PathOn-AI/PathOnRoboticsOSS/hardware/robots/so101_6dof_wrist/README.md

# SO-101 6DoF Wrist Upgrade





An upgrade kit for the [SO-101](https://github.com/TheRobotStudio/SO-ARM100) robotic arm, adding a **6th degree of freedom** (wrist pitch + yaw). The standard SO-101 is a 5DoF arm; two 3D-printed links replace the wrist so the arm can approach an object from any angle, which is what makes poses from off-the-shelf grasp-generation models reachable rather than merely computable.

Its companion is the [symmetric gripper](../../end_effectors/symmetric_gripper/) -- the two were designed together, and the gripper mounts onto the yaw link built here.

<p align="center">
  Assembled SO-101 6DoF with symmetric gripper
  <br>
  <em>Fully assembled SO-101 6DoF arm with symmetric gripper on a playground setup with overhead camera mount.</em>
</p>

<p align="center">
  MoveIt motion planning with point cloud
  <br>
  <em>RViz visualization showing MoveIt motion planning, robot model, TF frames, and point cloud overlay.</em>
</p>

## What's Included

Two printed links that replace the SO-101 wrist:

- `link_pitch` -- wrist pitch joint
- `link_yaw` -- wrist yaw joint

Plus the **simulation models for the whole arm**. `software/robot_assets/` holds the URDF and MJCF for the SO-101 with this wrist *and* the symmetric gripper as one kinematic chain -- there is no wrist-only or gripper-only model, so both live here.

## Prerequisites

You need a built [SO-101 arm](https://github.com/TheRobotStudio/SO-ARM100) as the base. This kit provides the parts for the 6DoF upgrade.

## Demos

The demos below exercise the complete assembly -- 6DoF wrist plus symmetric gripper.

### Vision-Language Grasping (Simulation)

We implement a vision-language grasping pipeline using SAM3 for segmentation and grasp generation models. Given a natural language command (e.g., "pick up the banana"), the system segments the target object and plans a grasp.

https://www.loom.com/share/2fed8ad63ee7416fad60bd227efd1a95

*Simulated pick-and-place with vision-language grasping.*

### MoveIt Motion Planning (Real Robot)

The real robot is integrated with ROS2 MoveIt for motion planning, with point cloud overlay for scene understanding.

https://www.loom.com/share/303cc35079a64f459af959ff9830bfd2

*MoveIt motion planning with point cloud overlay on the physical SO-101 6DoF arm.*

### Vision-Language Grasping (Real Robot)

Vision-language grasping running on the physical SO-101 6DoF arm.

https://www.loom.com/share/fe4379299d904ffc811d0ab0f7dc357c

*Real-robot pick-and-place with vision-language grasping.*

## Getting Started

1. Print the 3D parts -- see [hardware/](hardware/) for files and assembly instructions
2. Assemble the wrist upgrade onto your SO-101
3. Fit the [symmetric gripper](../../end_effectors/symmetric_gripper/)
4. Software integration -- coming soon

## 📰 News

| Date | Release |
|---|---|
| -- | Software release: digital twin, ROS2, MoveIt config, MuJoCo simulation (coming soon) |
| 2026-04-16 | Demo video: vision-language grasping (real robot) |
| 2026-04-14 | Software release: URDF, MJCF, and meshes for SO-101 6DoF symmetric gripper |
| 2026-04-13 | Assembly guide with images and print orientation for 6DoF wrist and gripper |
| 2026-04-12 | Bill of materials for 6DoF wrist upgrade and symmetric gripper |
| 2026-04-07 | Demo videos: vision-language grasping (simulation), MoveIt motion planning with point cloud (real robot) |
| 2026-04-07 | Hardware release: 6DoF wrist (pitch + yaw) STL/STEP files, symmetric gripper STL/STEP files |

## License

Hardware files in this project — CAD, meshes, assembly docs, and photos — are
covered by the [hardware LICENSE](../../LICENSE), a Standard Digital File License:

- **Personal use** — print, build, and modify these for your own personal,
  non-commercial use.
- **No redistribution** — do not repost the files or printed parts anywhere,
  free or paid, including remixes.
- **No organizational or commercial use** without written permission — this
  applies to companies, schools, and universities alike, and covers selling the
  files or prints *and* using the parts in a product, production line, service,
  course, or lab.

Licensing for organizations, including schools and universities, is available —
contact the copyright holder.

**Exception:** the meshes of the SO-101 arm body under
[`software/robot_assets/`](software/robot_assets/) are derived from
[SO-ARM100](https://github.com/TheRobotStudio/SO-ARM100) and remain under the
Apache License 2.0 — see the [NOTICE](software/robot_assets/NOTICE).
