PathOn-AI/PathOnRoboticsOSS/hardware/so101_6dof_symmetric_gripper/software/README.md

# Software

## Robot Assets

Robot description files and meshes for simulation and motion planning.

| File | Description |
|---|---|
| [URDF](robot_assets/so101_PathonAI_6dof_symmetric_gripper.urdf) | Robot description for ROS2 / RViz / MoveIt |
| [MJCF](robot_assets/so101_PathonAI_6dof_symmetric_gripper.xml) | MuJoCo simulation model |
| [meshes/](robot_assets/meshes/) | STL mesh files for all 9 links |

## Coming Soon

ROS2 integration, MoveIt config, digital twin, and MuJoCo simulation examples.
