PathOn-AI/PathOnRoboticsOSS/website/content/robots/amazing-hand.md

---
name: "Amazing Hand"
kind: "end_effector"
maker: "Pollen Robotics"
category: "Dexterous Hand"
description: "Self-contained, 3D-printed robotic hand with 8 DOF costing under €200, covered with TPU shell. Four fingers with two motors each."
link: "https://github.com/pollen-robotics/AmazingHand"
image: "/robots/amazing-hand.jpg"
specs:
  dof: "8"
  weight: "~0.3 kg"
  payload: "N/A"
  price: "< €200"
  controller: "Arduino / External"
  interfaces: "Serial, Python"
  power: "DC 5V"
  status: "Open Source / DIY"
purpose:
  - "Research"
  - "Hobby"
components:
  - name: "Micro Servos"
    type: "Actuators (x8)"
  - name: "3D-Printed Frame"
    type: "PLA"
  - name: "TPU Shell"
    type: "Protective Cover"
  - name: "Arduino Board"
    type: "Compute"
---

## Overview

The Amazing Hand by Pollen Robotics is a self-contained, 3D-printed dexterous robotic hand. It offers 8 degrees of freedom with four fingers (two motors each) at a cost under €200.

## Use Cases

- Dexterous manipulation research
- Grasping and in-hand manipulation
- Prosthetics prototyping
- Human-robot interaction studies
