PathOn-AI/PathOnRoboticsOSS/website/content/robots/cyberbrick.md

---
name: "CyberBrick by Bambu Lab"
kind: "robot"
maker: "Bambu Lab"
category: "DIY Kits"
description: "Modular hardware kit enabling 3D printing designers to build functional robots — arms, combat robots, vehicles, and droids."
link: "https://makerworld.com/en/cyberbrick"
image: "/robots/cyberbrick.png"
specs:
  dof: "Varies by build"
  price: "~$50+ (modules)"
  controller: "CyberBrick Controller"
  interfaces: "Bambu App, Bluetooth"
  power: "Li-Ion Battery Pack"
  status: "Commercial / DIY"
purpose:
  - "Hobby"
  - "Education"
components:
  - name: "CyberBrick Servo Modules"
    type: "Actuators"
  - name: "CyberBrick Controller"
    type: "Compute"
  - name: "3D-Printed Parts"
    type: "Frame (MakerWorld)"
  - name: "Battery Module"
    type: "Power"
---

## Overview

CyberBrick by Bambu Lab is a modular hardware kit that brings 3D-printed robots to life. It provides standardized electronic modules that snap into 3D-printed structures, enabling makers to build functional robots without complex wiring.

## Community Projects

The CyberBrick ecosystem on MakerWorld includes robotic arms, combat robots, RC vehicles, walking robots, and custom animatronics.

## Use Cases

- STEM education and maker projects
- Rapid prototyping of robot designs
- Community-driven robot building
- Introduction to robotics for beginners
