PathOn-AI/PathOnRoboticsOSS/website/content/robots/jetauto-pro.md

---
name: "HIWONDER JetAuto Pro"
kind: "robot"
maker: "Hiwonder"
category: "Mobile Manipulator"
description: "ROS2-enabled autonomous vehicle platform for navigation and perception research."
link: "https://www.amazon.com/dp/B0C2VZLJCL"
image: "/robots/jetauto-pro.jpg"
specs:
  dof: "4 (base) + 4 (arm)"
  weight: "~3 kg"
  payload: "~200 g (arm)"
  price: "~$800"
  controller: "NVIDIA Jetson Nano"
  interfaces: "ROS2, Python, OpenCV"
  power: "Rechargeable Li-Ion"
  status: "Commercial"
purpose:
  - "Education"
  - "Research"
components:
  - name: "NVIDIA Jetson Nano"
    type: "Onboard Compute"
  - name: "4-DOF Robotic Arm"
    type: "Manipulator"
  - name: "Mecanum Wheels"
    type: "Drive (x4)"
  - name: "Depth Camera"
    type: "Vision"
  - name: "LiDAR"
    type: "Navigation"
---

## Overview

The HIWONDER JetAuto Pro is a ROS2-enabled autonomous vehicle platform combining a mobile base with a robotic arm. It is designed for integrated navigation, perception, and manipulation research.

## Use Cases

- Mobile manipulation research
- Autonomous driving and navigation
- Object detection and pick-and-place
- Multi-task robot learning
