PathOn-AI/PathOnRoboticsOSS/website/content/robots/mentorpi.md

---
name: "Hiwonder MentorPi"
kind: "robot"
maker: "Hiwonder"
category: "Mobile Base"
description: "ROS2 robot powered by Raspberry Pi 5 with 3D depth camera, TOF LiDAR, and SLAM navigation. Three chassis variants available."
link: "https://www.hiwonder.com/products/mentorpi-m1"
image: "/robots/mentorpi.jpg"
specs:
  dof: "4 (varies by chassis)"
  weight: "~2 kg"
  price: "~$400"
  controller: "Raspberry Pi 5"
  interfaces: "ROS2, Python, OpenCV"
  power: "Rechargeable Li-Ion"
  status: "Commercial"
purpose:
  - "Education"
components:
  - name: "Raspberry Pi 5"
    type: "Onboard Compute"
  - name: "3D Depth Camera"
    type: "Vision"
  - name: "TOF LiDAR"
    type: "Range Sensor"
  - name: "Mecanum / Ackermann / Tank Chassis"
    type: "Drive Base (3 options)"
---

## Overview

The Hiwonder MentorPi is a ROS2 educational mobile robot powered by Raspberry Pi 5. It comes with a rich sensor suite and offers three interchangeable chassis options: Mecanum, Ackermann, and tank treads.

## Use Cases

- ROS2 education and curriculum development
- SLAM and navigation experiments
- Multi-sensor fusion research
- Comparing different locomotion strategies
