PathOn-AI/PathOnRoboticsOSS/website/content/robots/mycobot-280.md

---
name: "Elephant Robotics myCobot 280 Pi"
kind: "robot"
maker: "Elephant Robotics"
category: "Robotic Arm"
description: "6-DOF collaborative robot powered by Raspberry Pi 4B. Supports Python, C++, ROS, and Arduino with AI kit and adaptive gripper."
link: "https://shop.elephantrobotics.com/collections/mycobot-280/products/holiday-mycobot-pi-raspberry-pi-powered-6-dof-collaborative-robot"
image: "/robots/mycobot-280.jpg"
specs:
  dof: "6"
  weight: "0.98 kg"
  payload: "250 g"
  reach: "280 mm"
  price: "~$600"
  controller: "Raspberry Pi 4B"
  interfaces: "Python, C++, ROS, ROS2, Arduino"
  power: "DC 12V"
  repeatability: "±0.5 mm"
  status: "Commercial"
purpose:
  - "Education"
  - "Research"
components:
  - name: "Custom Serial Servos"
    type: "Servos (x6)"
  - name: "Raspberry Pi 4B"
    type: "Onboard Compute"
  - name: "Adaptive Gripper"
    type: "End Effector"
  - name: "AI Kit Camera"
    type: "Vision (optional)"
---

## Overview

The myCobot 280 Pi is a compact 6-DOF collaborative robot arm from Elephant Robotics, powered by a Raspberry Pi 4B. It is designed for education, research, and light industrial applications.

## Use Cases

- ROS2 development and education
- Visual servoing and pick-and-place
- Lightweight manipulation research
