PathOn-AI/PathOnRoboticsOSS/website/content/robots/puppypi.md

---
name: "Hiwonder PuppyPi"
kind: "robot"
maker: "Hiwonder"
category: "Quadruped"
description: "ROS quadruped robot powered by Raspberry Pi 5 with AI vision, 8 coreless servos, OpenCV, and SLAM mapping."
link: "https://www.hiwonder.com/products/puppypi"
image: "/robots/puppypi.jpg"
specs:
  dof: "8"
  weight: "~0.6 kg"
  price: "~$300"
  controller: "Raspberry Pi 5"
  interfaces: "ROS, Python, OpenCV"
  power: "Li-Ion 7.4V"
  status: "Commercial"
purpose:
  - "Education"
  - "Hobby"
components:
  - name: "Coreless Servos"
    type: "Actuators (x8)"
  - name: "Raspberry Pi 5"
    type: "Onboard Compute"
  - name: "USB Camera"
    type: "Vision"
  - name: "LiDAR"
    type: "Navigation (optional)"
  - name: "Robotic Arm"
    type: "Manipulator (optional)"
---

## Overview

The Hiwonder PuppyPi is a ROS-compatible quadruped robot powered by Raspberry Pi 5. It features AI-powered vision with OpenCV and 8 coreless servos for dynamic walking gaits.

## Use Cases

- Quadruped locomotion research
- Legged robot gait learning
- Computer vision on mobile platforms
- STEM education
