PathOn-AI/PathOnRoboticsOSS/website/content/robots/rosmaster-x3.md

---
name: "ROSMASTER X3 ROS2 Robot"
kind: "robot"
maker: "Yahboom"
category: "Mobile Base"
description: "Mecanum wheel robot enabling omnidirectional movement for ROS2 development."
link: "https://www.robotshop.com/products/yahboom-rosmaster-x3-ros2-robot-with-mecanum-wheel-advanced-without-orin-super-board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"
image: "/robots/rosmaster-x3.jpg"
specs:
  dof: "4 (mecanum wheels)"
  weight: "~2.5 kg"
  payload: "~3 kg"
  price: "~$500"
  controller: "NVIDIA Jetson / Raspberry Pi"
  interfaces: "ROS2, Python"
  power: "Li-Ion 12.6V"
  status: "Commercial"
purpose:
  - "Education"
  - "Research"
components:
  - name: "Mecanum Wheels"
    type: "Drive (x4)"
  - name: "NVIDIA Jetson Orin"
    type: "Compute (optional)"
  - name: "Depth Camera"
    type: "Vision"
  - name: "LiDAR"
    type: "2D LiDAR"
  - name: "IMU"
    type: "Inertial Sensor"
---

## Overview

The ROSMASTER X3 by Yahboom is a ROS2-compatible mobile robot featuring mecanum wheels for omnidirectional movement. It is a versatile platform for navigation and perception research.

## Use Cases

- Omnidirectional navigation research
- Indoor autonomous delivery prototyping
- SLAM and mapping with various sensor configurations
- Mobile manipulation base platform
