PathOn-AI/PathOnRoboticsOSS/website/content/robots/turtlebot4.md

---
name: "Clearpath Robotics TurtleBot 4"
kind: "robot"
maker: "Clearpath Robotics"
category: "Mobile Base"
description: "Industry-standard mobile robot for ROS2 development and education."
link: "https://www.robotshop.com/products/clearpath-robotics-turtlebot-4-mobile-robot?variant=42360573362337"
image: "/robots/turtlebot4.jpg"
specs:
  dof: "2 (differential drive)"
  weight: "~3.4 kg"
  payload: "~9 kg"
  price: "~$1,200"
  controller: "Raspberry Pi 4"
  interfaces: "ROS2, Nav2, Python"
  power: "Rechargeable Li-Ion"
  status: "Commercial"
purpose:
  - "Education"
  - "Research"
components:
  - name: "iRobot Create 3"
    type: "Drive Base"
  - name: "Raspberry Pi 4"
    type: "Onboard Compute"
  - name: "RPLIDAR A1"
    type: "2D LiDAR"
  - name: "OAK-D Camera"
    type: "Depth Camera"
  - name: "IMU"
    type: "Inertial Sensor"
---

## Overview

The TurtleBot 4 by Clearpath Robotics is the industry-standard mobile robot platform for ROS2 development. Built on the iRobot Create 3, it is the go-to platform for learning and teaching ROS2 navigation and perception.

## Use Cases

- ROS2 navigation and SLAM education
- Autonomous mobile robot research
- Multi-robot coordination experiments
- Perception and mapping benchmarks
