PathOn-AI/PathOnRoboticsOSS/software/iphone_sensor_suite/images/iphone_aruco.png

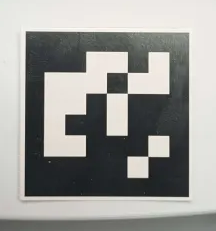
software/iphone_sensor_suite/images/iphone_aruco.png
