PathOn-AI/PathOnRoboticsOSS/software/iphone_sensor_suite/images/iphone_aruco_orientation.png

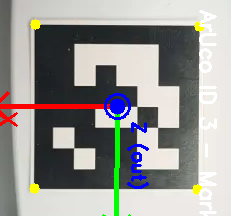
software/iphone_sensor_suite/images/iphone_aruco_orientation.png
