PathOn-AI/PathOnRoboticsOSS/software/iphone_sensor_suite/Scanner3D/example_scan/2026-03-23--19-45-00/capture_000001/depth_vis.png

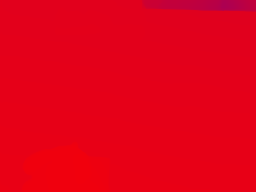
software/iphone_sensor_suite/Scanner3D/example_scan/2026-03-23--19-45-00/capture_000001/depth_vis.png
