PathOn-AI/PathOnRoboticsOSS/hardware/end_effectors/symmetric_gripper/hardware/3d_printed_parts/symmetric_gripper/step/Parallel_gripper_assembly.step

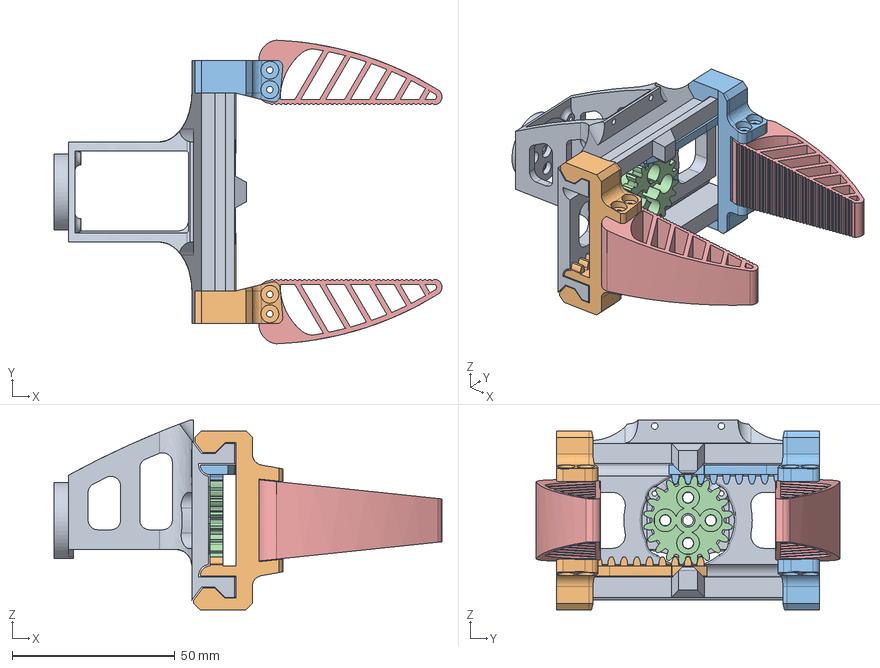
[picture p60: CAD file, 2026-07-22]
hardware/end_effectors/symmetric_gripper/hardware/3d_printed_parts/symmetric_gripper/step/Parallel_gripper_assembly.step
119.3 x 93.4 x 58.4 mm
