PathOn-AI/PathOnRoboticsOSS/hardware/end_effectors/dexterous_hand/v3/stl/thumb_finger_link.stl

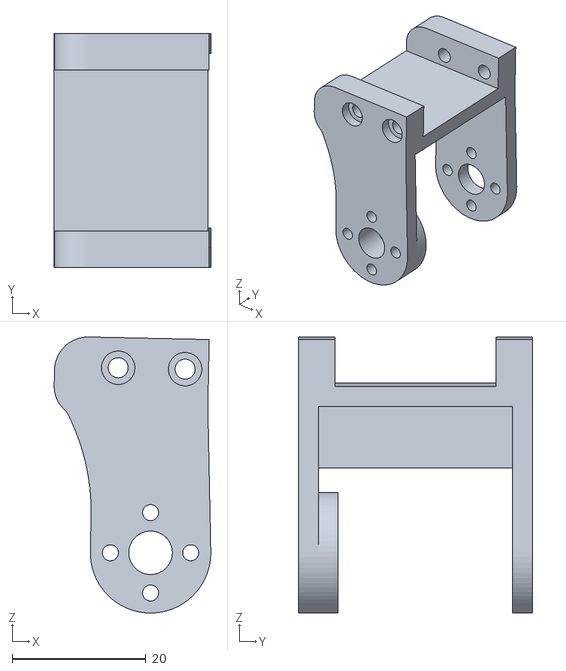
[picture p62: CAD file, 2026-11-03]
hardware/end_effectors/dexterous_hand/v3/stl/thumb_finger_link.stl
23.4 x 35.0 x 41.2
