PathOn-AI/PathOnRoboticsOSS/hardware/end_effectors/symmetric_gripper/hardware/3d_printed_parts/symmetric_gripper/stl/l_gripper.stl

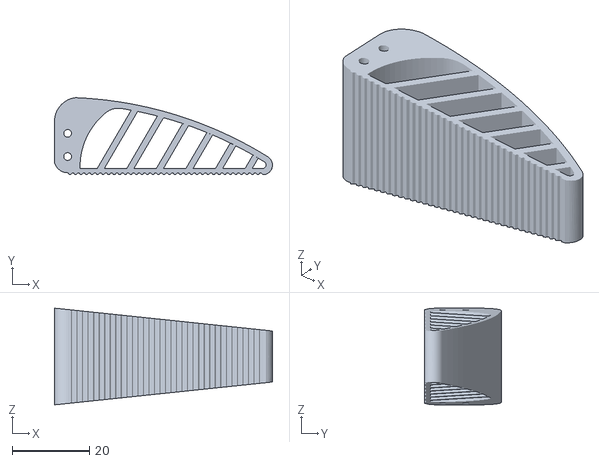
[picture p63: CAD file, 2026-07-22]
hardware/end_effectors/symmetric_gripper/hardware/3d_printed_parts/symmetric_gripper/stl/l_gripper.stl
56.3 x 19.8 x 25.0
