PathOn-AI/PathOnRoboticsOSS/hardware/mounts/livox_mid360_go2_mount/cad/livox_mid360_mount.stl

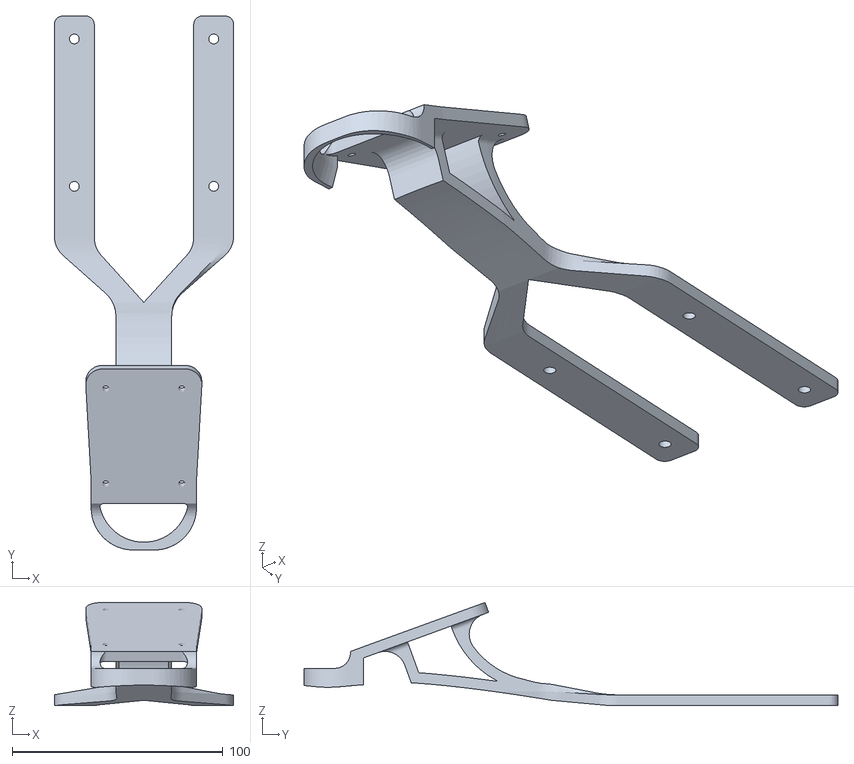
[picture p64: CAD file, 2026-05-06]
hardware/mounts/livox_mid360_go2_mount/cad/livox_mid360_mount.stl
85.2 x 253.6 x 48.9
