PathOn-AI/PathOnRoboticsOSS/hardware/robots/openarm_leader/cad_files/step/waveshare_mount.step

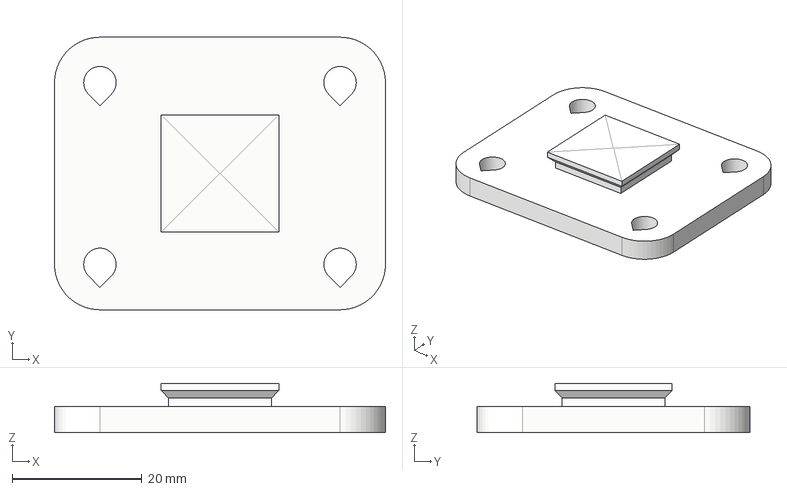
[picture p65: CAD file, 2026-10-23]
hardware/robots/openarm_leader/cad_files/step/waveshare_mount.step
51.0 x 42.0 x 7.60 mm
