PathOn-AI/PathOnRoboticsOSS/hardware/robots/openarm_leader/cad_files/stl/j4.stl

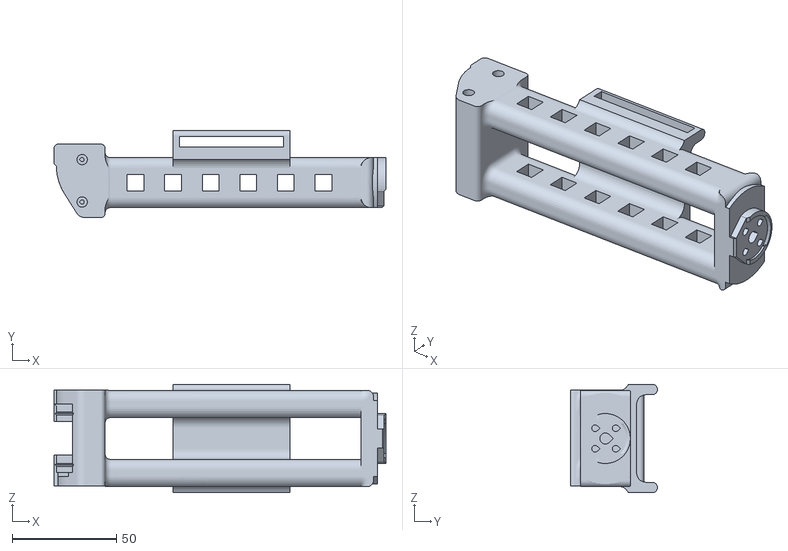
[picture p66: CAD file, 2026-10-23]
hardware/robots/openarm_leader/cad_files/stl/j4.stl
159.2 x 41.7 x 52.0
