PathOn-AI/PathOnRoboticsOSS/hardware/robots/piper_leader/cad/piper_leader.step

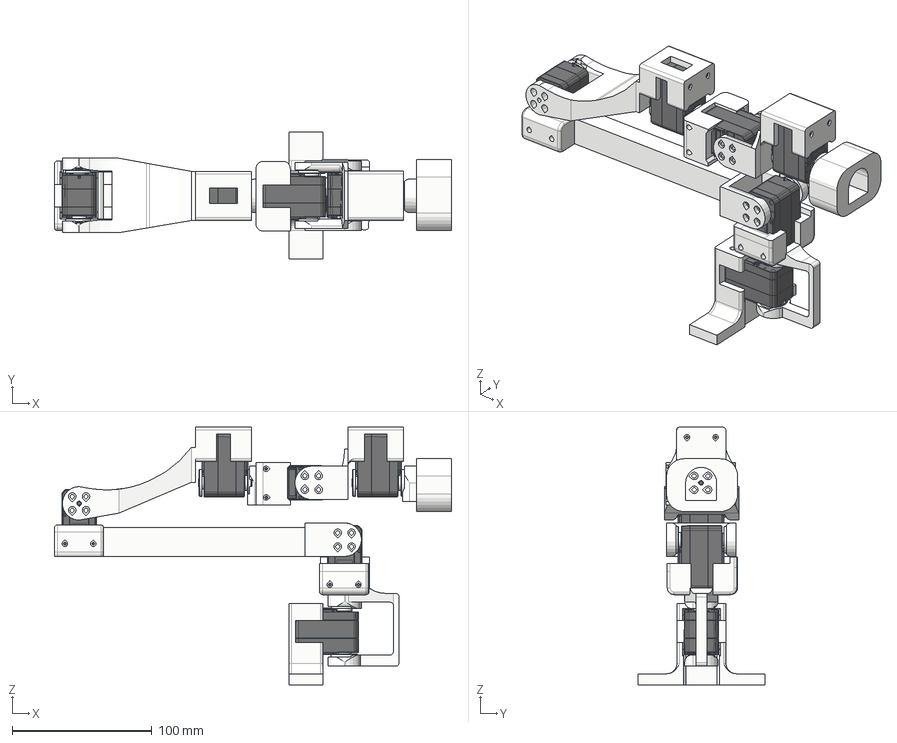
[picture p67: CAD file, 2026-07-14]
hardware/robots/piper_leader/cad/piper_leader.step
284.5 x 91.2 x 184.6 mm
Upper_arm_SO101
ZK_122 x 2
SG-ZIJI_15 x 2
XG-ZIJI_16 x 2
MOTOR-1723_3 x 2
PCB-CHAZUO_92 x 2
GE_27 x 2
金属舵盘（驱动） x 2
金属舵盘（从动） x 2
Upper_arm_SO101_1
ZK_122_1 x 4
SG-ZIJI_15_1 x 4
XG-ZIJI_16_1 x 4
MOTOR-1723_3_1 x 4
PCB-CHAZUO_92_1 x 4
GE_27_1 x 4
金属舵盘（驱动）_1 x 4
金属舵盘（从动）_1 x 4
Upper_arm_SO101_2
Upper_arm_SO101_3
Upper_arm_SO101_4
Upper_arm_SO101_5
Upper_arm_SO101_6
