PathOn-AI/PathOnRoboticsOSS/hardware/robots/piper_leader/cad/stl/lower_arm.stl

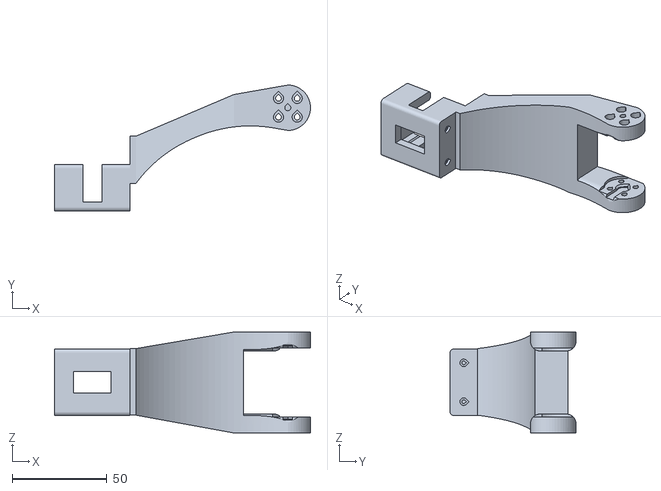
[picture p68: CAD file, 2026-10-23]
hardware/robots/piper_leader/cad/stl/lower_arm.stl
135.4 x 66.6 x 53.4
