PathOn-AI/PathOnRoboticsOSS/hardware/robots/piper_leader/stl/pitch.stl

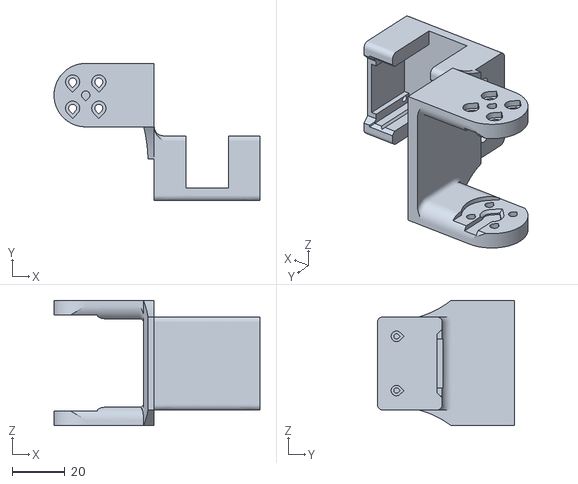
[picture p69: CAD file, 2026-10-22]
hardware/robots/piper_leader/stl/pitch.stl
77.9 x 51.9 x 47.4
