PathOn-AI/PathOnRoboticsOSS/hardware/robots/so101_6dof_wrist/hardware/3d_printed_parts/6dof/step/link_pitch.step

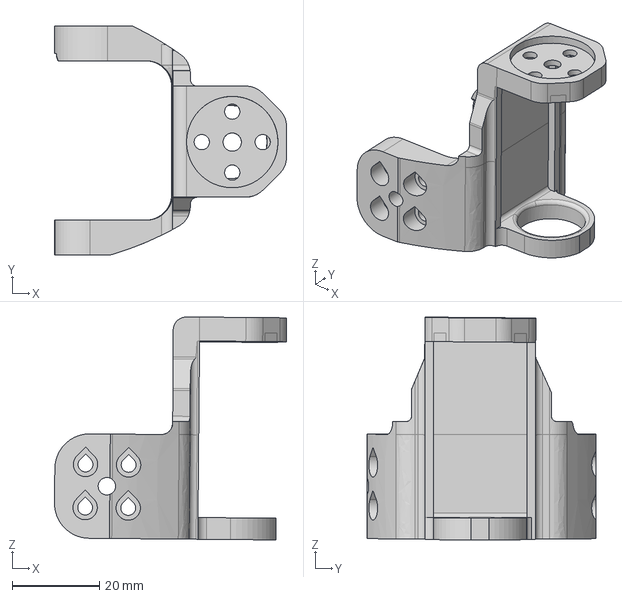
[picture p70: CAD file, 2026-04-14]
hardware/robots/so101_6dof_wrist/hardware/3d_printed_parts/6dof/step/link_pitch.step
53.3 x 52.6 x 51.2 mm
