PathOn-AI/PathOnRoboticsOSS/hardware/robots/so101_6dof_wrist/software/robot_assets/meshes/right_jaw_v1_1.stl

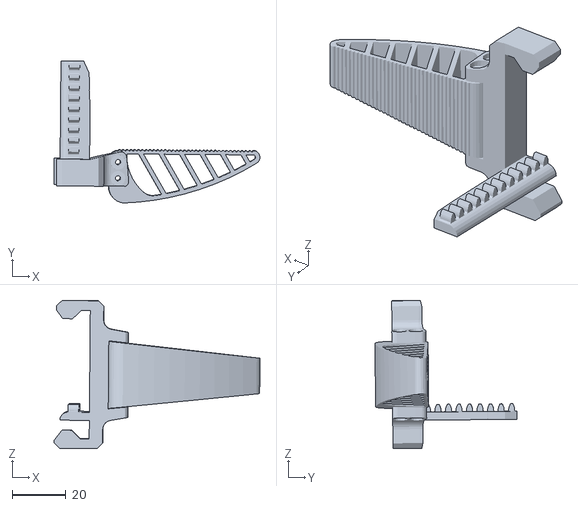
[picture p71: CAD file, 2026-04-14]
hardware/robots/so101_6dof_wrist/software/robot_assets/meshes/right_jaw_v1_1.stl
76.8 x 53.0 x 55.3
