PathOn-AI/PathOnRoboticsOSS/hardware/so101_6dof_symmetric_gripper/hardware/3d_printed_parts/6dof/step/link_yaw.step

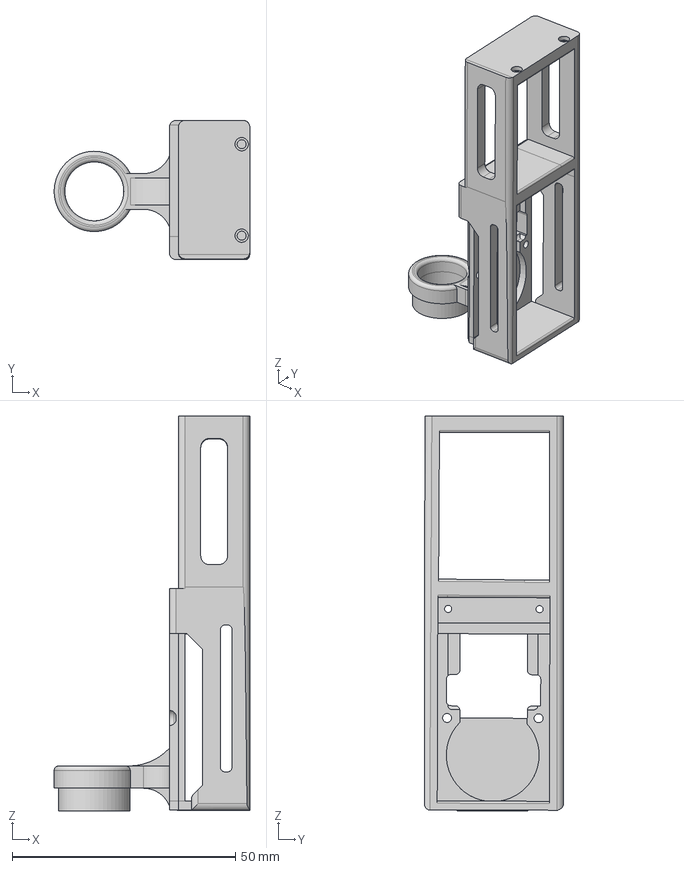
[picture p72: CAD file, 2026-04-14]
hardware/so101_6dof_symmetric_gripper/hardware/3d_printed_parts/6dof/step/link_yaw.step
43.8 x 31.2 x 88.5 mm
