PathOn-AI/PathOnRoboticsOSS/hardware/so101_6dof_symmetric_gripper/software/robot_assets/meshes/link_roll_v1_1.stl

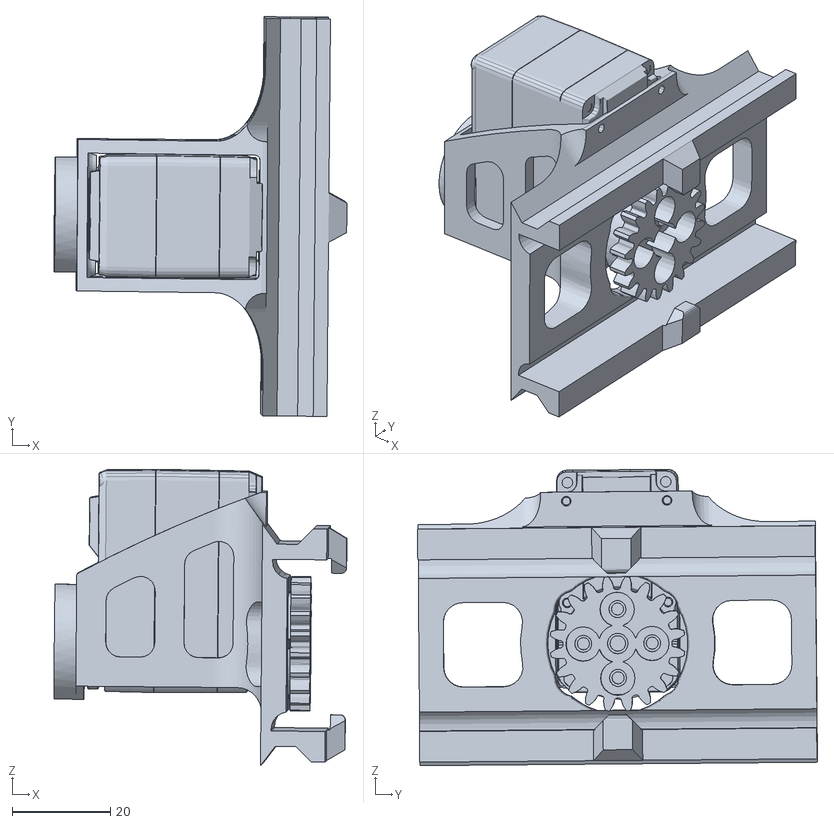
[picture p73: CAD file, 2026-04-14]
hardware/so101_6dof_symmetric_gripper/software/robot_assets/meshes/link_roll_v1_1.stl
59.6 x 81.3 x 60.3
