PathOn-AI/PathOnRoboticsOSS/software/diy_pipeline/robot-assets-skills/robots/allegro_right/assets/base_link_left.stl

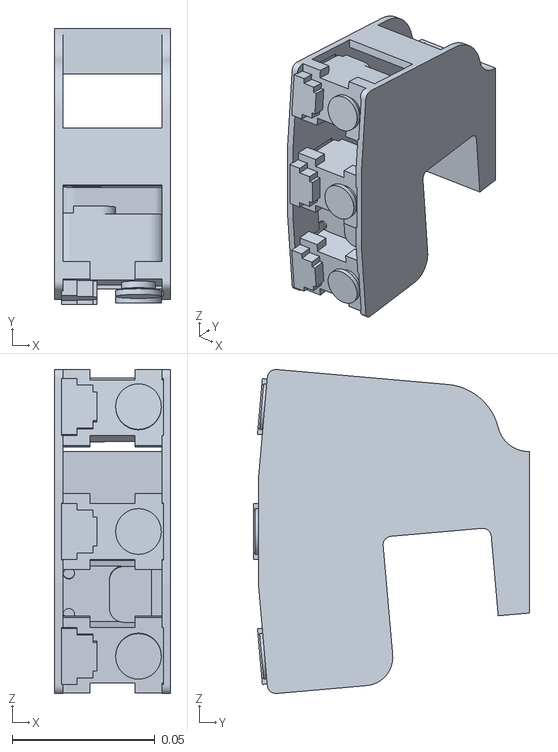
[picture p74: CAD file, 2026-05-08]
software/diy_pipeline/robot-assets-skills/robots/allegro_right/assets/base_link_left.stl
0.0408 x 0.0967 x 0.113
