PathOn-AI/PathOnRoboticsOSS/software/diy_pipeline/robot-assets-skills/robots/allegro_right/meshes/link_0.0.STL

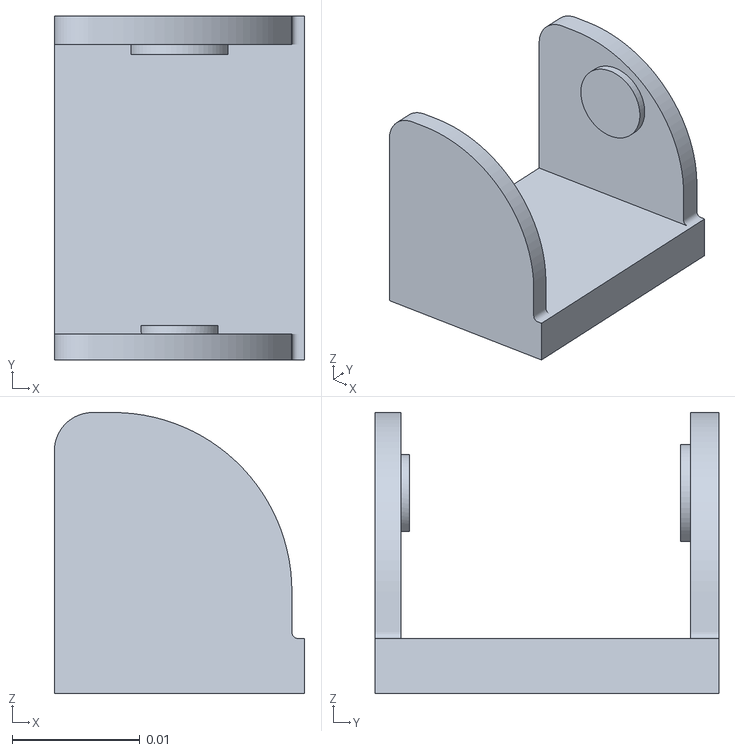
[picture p75: CAD file, 2026-05-08]
software/diy_pipeline/robot-assets-skills/robots/allegro_right/meshes/link_0.0.STL
0.0196 x 0.0269 x 0.022
