PathOn-AI/PathOnRoboticsOSS/software/diy_pipeline/robot-assets-skills/robots/piper_arm/assets/base_link.stl

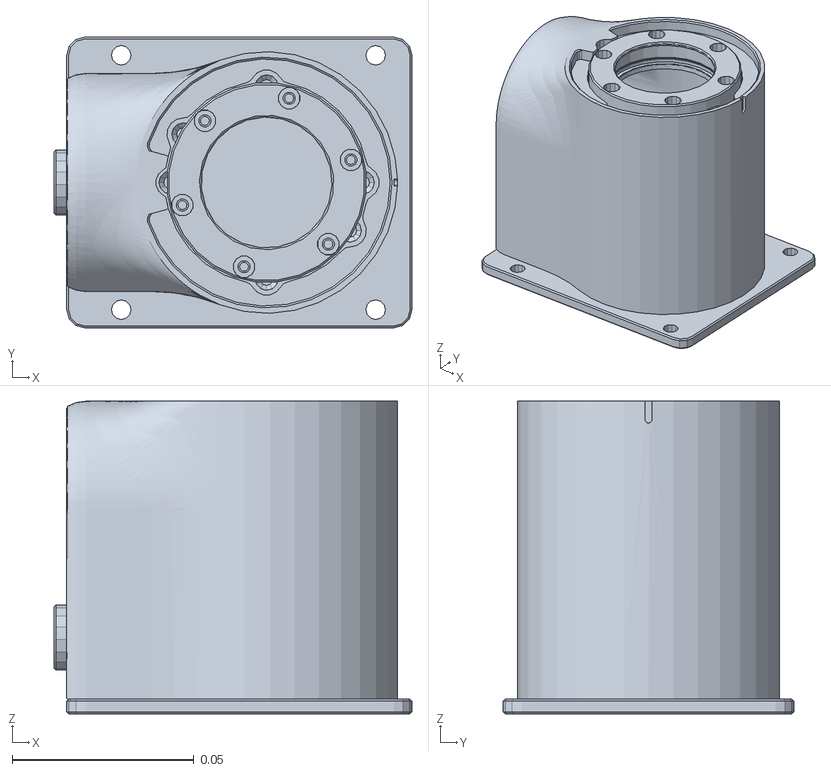
[picture p76: CAD file, 2026-05-08]
software/diy_pipeline/robot-assets-skills/robots/piper_arm/assets/base_link.stl
0.0985 x 0.08 x 0.086
