PathOn-AI/PathOnRoboticsOSS/software/diy_pipeline/robot-assets-skills/robots/piper_arm/meshes/link1.STL

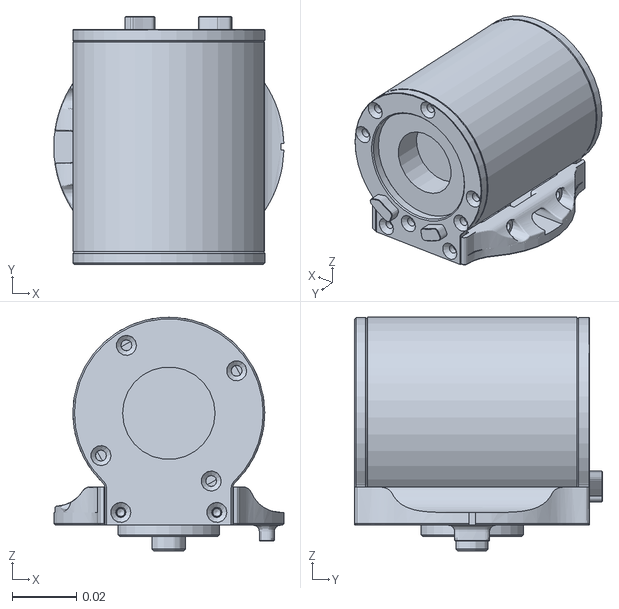
[picture p77: CAD file, 2026-05-08]
software/diy_pipeline/robot-assets-skills/robots/piper_arm/meshes/link1.STL
0.0719 x 0.0775 x 0.073
