PathOn-AI/PathOnRoboticsOSS/hardware/end_effectors/dexterous_hand/v3/cad/Part16_straight^dex_hand.SLDPRT

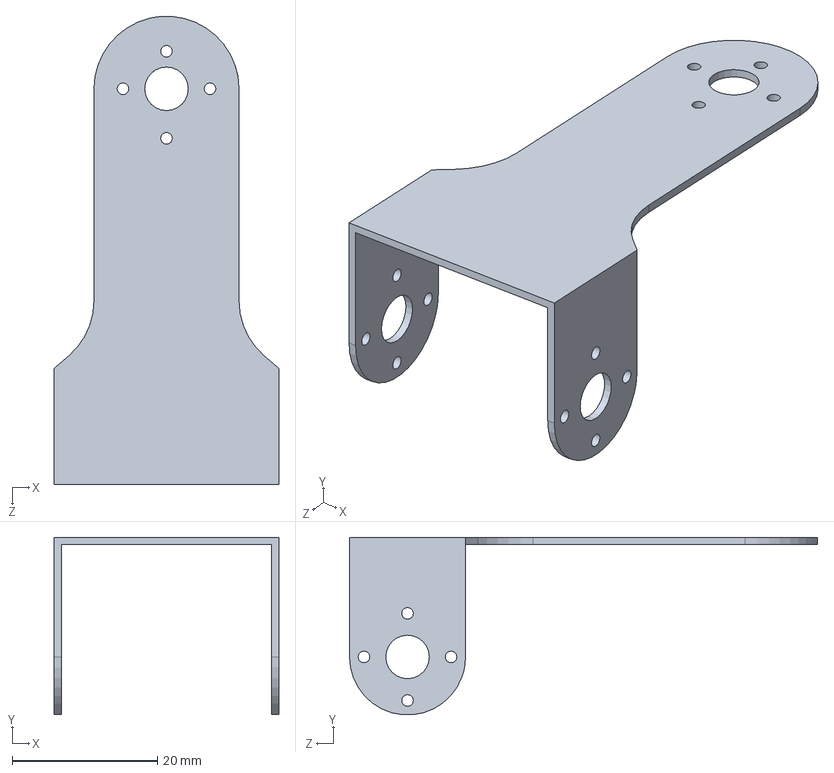
[picture p78: CAD file, 2026-08-09]
hardware/end_effectors/dexterous_hand/v3/cad/Part16_straight^dex_hand.SLDPRT
31.0 x 24.5 x 64.5 mm
