PathOn-AI/PathOnRoboticsOSS/hardware/end_effectors/dexterous_hand/v3/stl/soft_fin_half_mod.stl

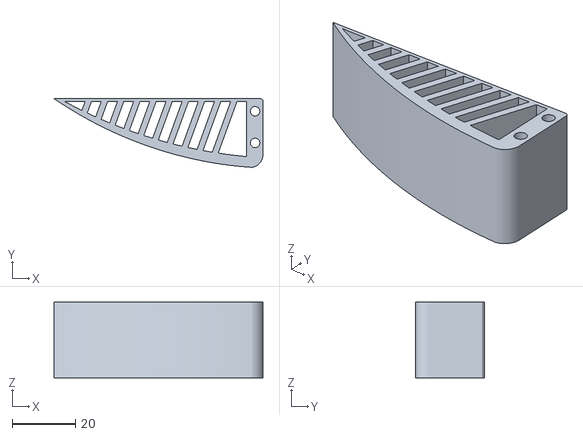
[picture p79: CAD file, 2026-11-03]
hardware/end_effectors/dexterous_hand/v3/stl/soft_fin_half_mod.stl
66.0 x 21.7 x 24.0
