PathOn-AI/PathOnRoboticsOSS/hardware/robots/openarm_leader/cad_files/step/j6.step

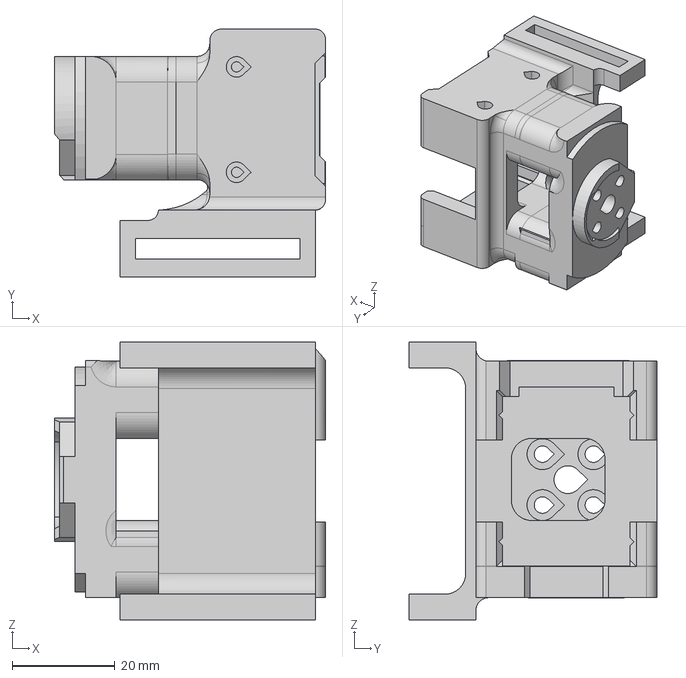
[picture p80: CAD file, 2026-10-23]
hardware/robots/openarm_leader/cad_files/step/j6.step
52.7 x 48.2 x 54.0 mm
Under_arm_SO101 v1
