PathOn-AI/PathOnRoboticsOSS/hardware/robots/piper_leader/stl/upper_arm.stl

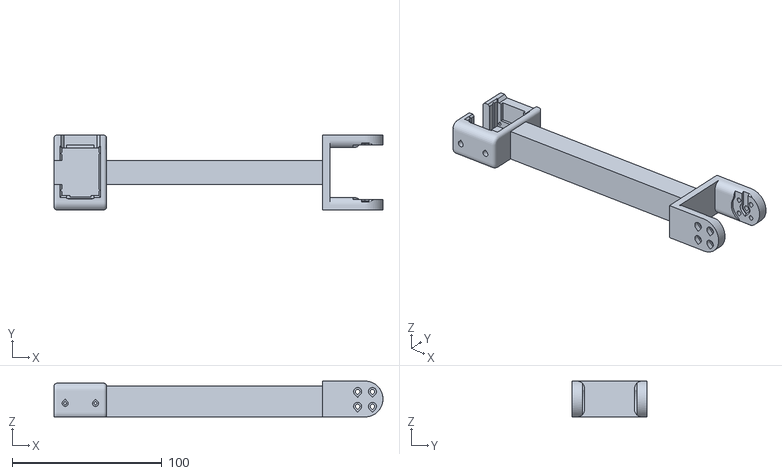
[picture p81: CAD file, 2026-10-22]
hardware/robots/piper_leader/stl/upper_arm.stl
219.9 x 50.1 x 24.0
