PathOn-AI/PathOnRoboticsOSS/hardware/so101_6dof_symmetric_gripper/software/robot_assets/meshes/lower_arm_link_1.stl

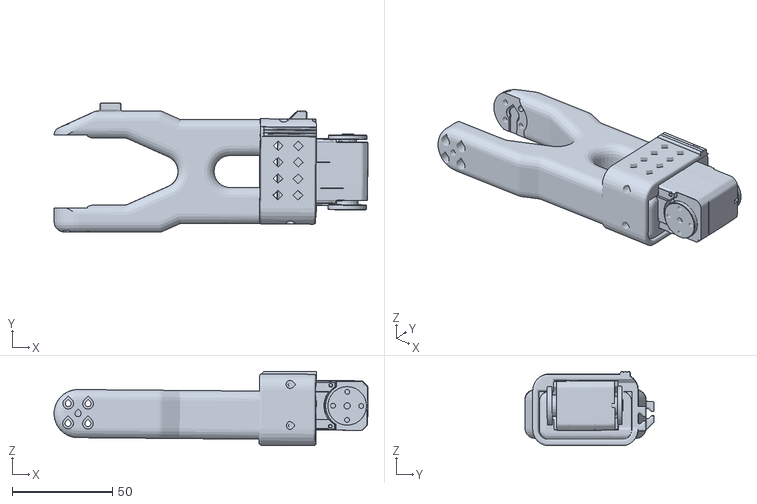
[picture p82: CAD file, 2026-04-14]
hardware/so101_6dof_symmetric_gripper/software/robot_assets/meshes/lower_arm_link_1.stl
156.5 x 64.4 x 37.1
