PathOn-AI/PathOnRoboticsOSS/software/diy_pipeline/robot-assets-skills/robots/piper_arm/assets/link3_8.obj

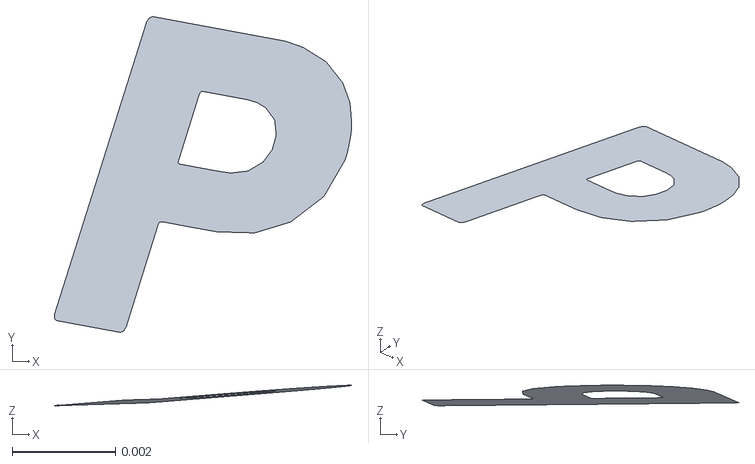
[picture p84: CAD file, 2026-05-08]
software/diy_pipeline/robot-assets-skills/robots/piper_arm/assets/link3_8.obj
0.00577 x 0.00613 x 0.000399
