PathOn-AI/PathOnRoboticsOSS/software/diy_pipeline/robot-assets-skills/robots/piper_arm/meshes/link4.STL

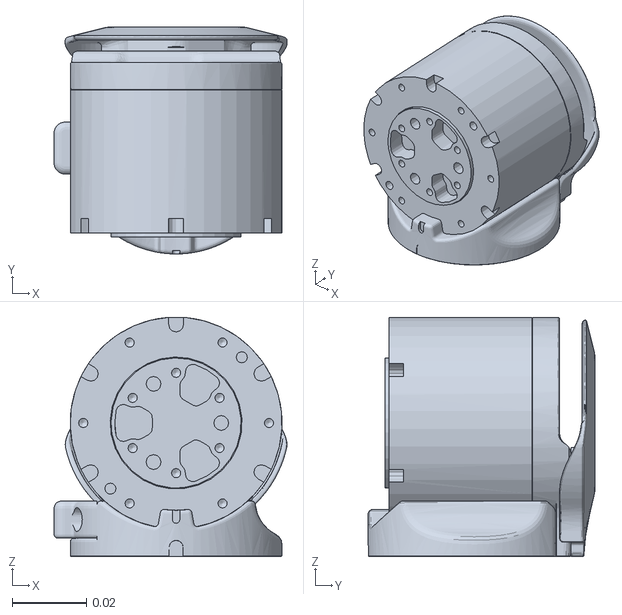
[picture p85: CAD file, 2026-05-08]
software/diy_pipeline/robot-assets-skills/robots/piper_arm/meshes/link4.STL
0.0627 x 0.0611 x 0.0644
