PathOn-AI/PathOnRoboticsOSS/hardware/end_effectors/dexterous_hand/v3/cad/XL,XC-330.stp

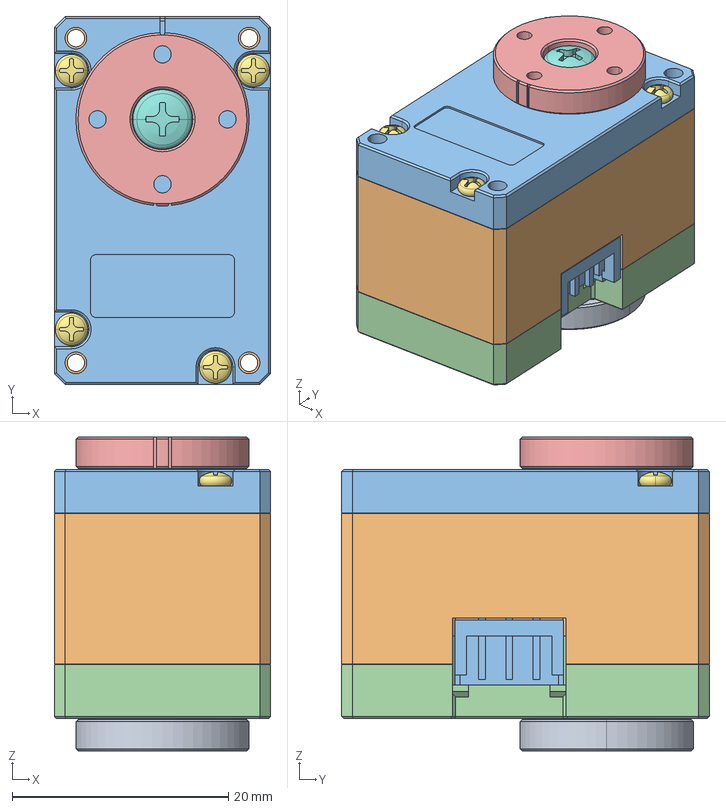
[picture p86: CAD file, 2026-08-09]
hardware/end_effectors/dexterous_hand/v3/cad/XL,XC-330.stp
20.0 x 34.0 x 29.0 mm
DC15_A01_CASE_M_DUMMY
DC15_A01_CASE_F_DUMMY
DC15_A01_CASE_B_DUMMY
DC15_A01_HORN_DUMMY
DC15_A01_LED_CAP2_DUMMY
PHS_1_7X20_5_DC10 x 4
BTS2_M2_6X8 x 2
DC15_A01_HORN_IDLE2_DUMMY
DC15_A01_IDLE_CAP_DUMMY
B3B-EH x 2
