PathOn-AI/PathOnRoboticsOSS/hardware/end_effectors/dexterous_hand/v3/stl/arm_J7_A.stl

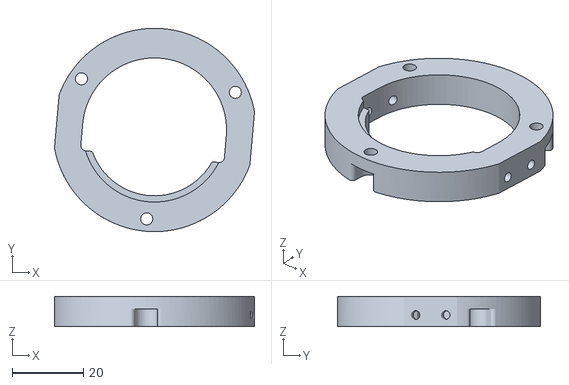
[picture p87: CAD file, 2026-11-03]
hardware/end_effectors/dexterous_hand/v3/stl/arm_J7_A.stl
56.1 x 57.0 x 8.50
