PathOn-AI/PathOnRoboticsOSS/hardware/end_effectors/symmetric_gripper/hardware/3d_printed_parts/symmetric_gripper/stl/rack_up.stl

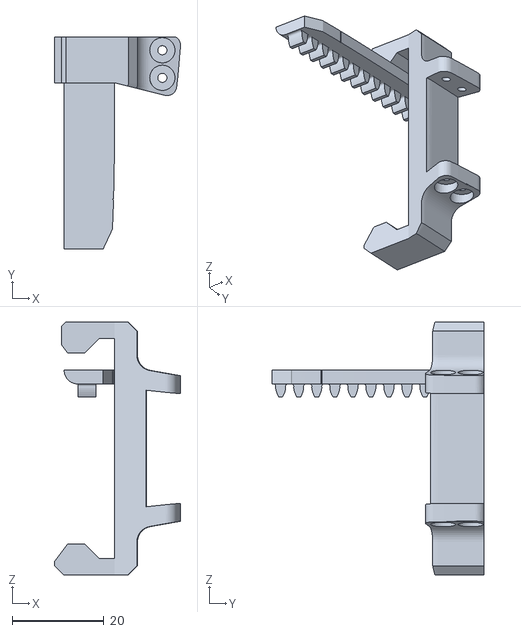
[picture p88: CAD file, 2026-04-14]
hardware/end_effectors/symmetric_gripper/hardware/3d_printed_parts/symmetric_gripper/stl/rack_up.stl
27.5 x 46.2 x 55.1
