PathOn-AI/PathOnRoboticsOSS/hardware/robots/openarm_leader/cad_files/step/j5.step

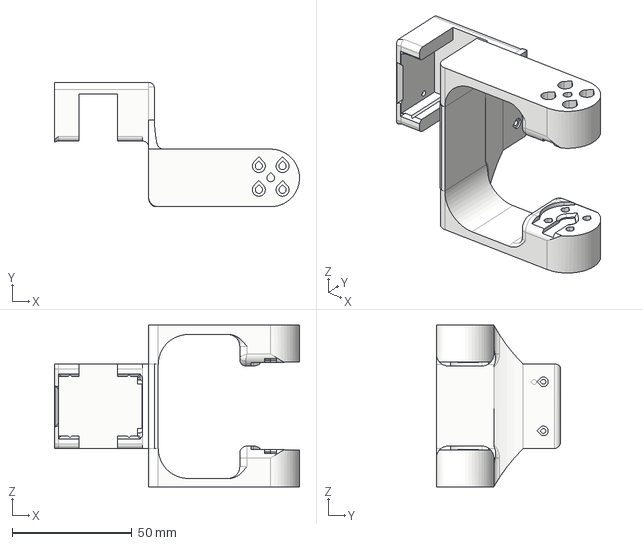
[picture p89: CAD file, 2026-10-23]
hardware/robots/openarm_leader/cad_files/step/j5.step
102.1 x 51.9 x 67.4 mm
