PathOn-AI/PathOnRoboticsOSS/hardware/robots/piper_leader/stl/roll_2.stl

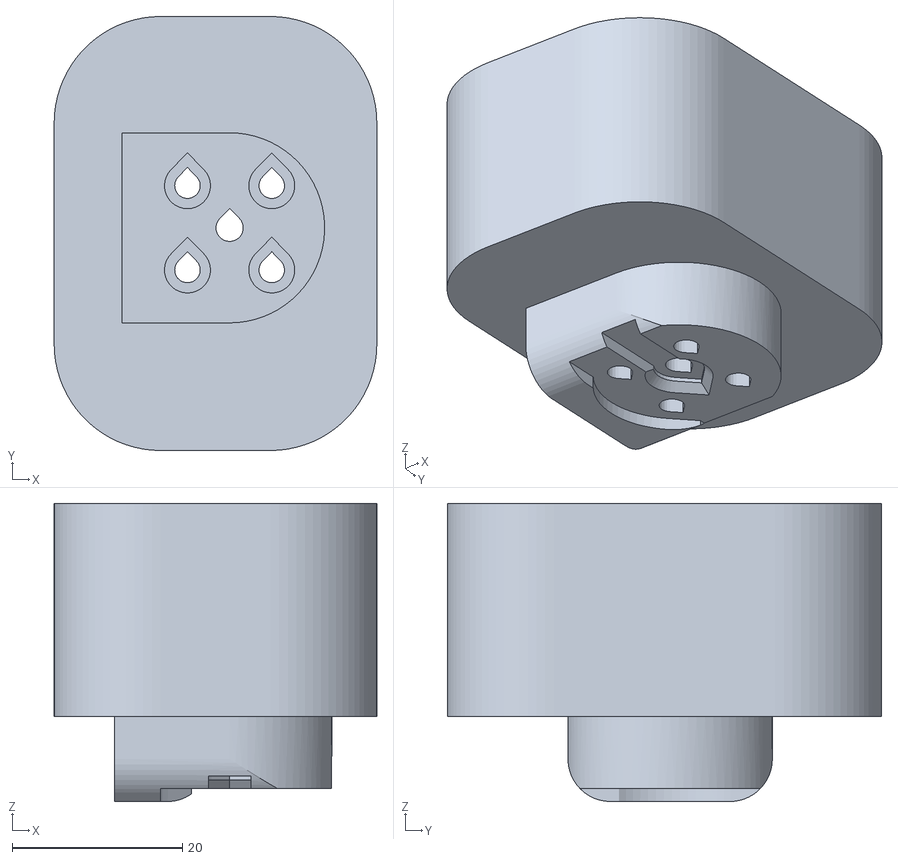
[picture p90: CAD file, 2026-07-14]
hardware/robots/piper_leader/stl/roll_2.stl
37.9 x 51.0 x 35.0
