PathOn-AI/PathOnRoboticsOSS/hardware/robots/so101_6dof_wrist/software/robot_assets/meshes/link_yaw_v1_1.stl

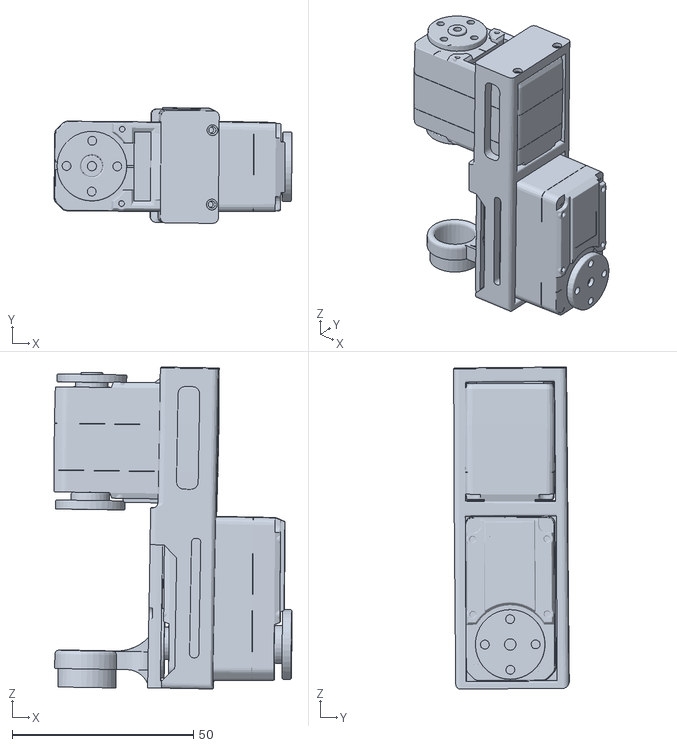
[picture p91: CAD file, 2026-04-14]
hardware/robots/so101_6dof_wrist/software/robot_assets/meshes/link_yaw_v1_1.stl
65.6 x 31.9 x 88.8
