PathOn-AI/PathOnRoboticsOSS/hardware/so101_6dof_symmetric_gripper/software/robot_assets/meshes/base_link.stl

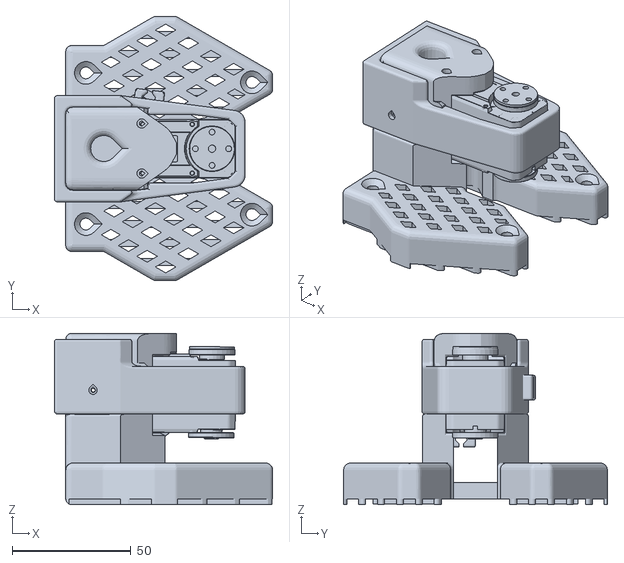
[picture p92: CAD file, 2026-04-14]
hardware/so101_6dof_symmetric_gripper/software/robot_assets/meshes/base_link.stl
91.8 x 110.9 x 72.0
