PathOn-AI/PathOnRoboticsOSS/software/diy_pipeline/robot-assets-skills/robots/piper_arm/assets/link3_3.obj

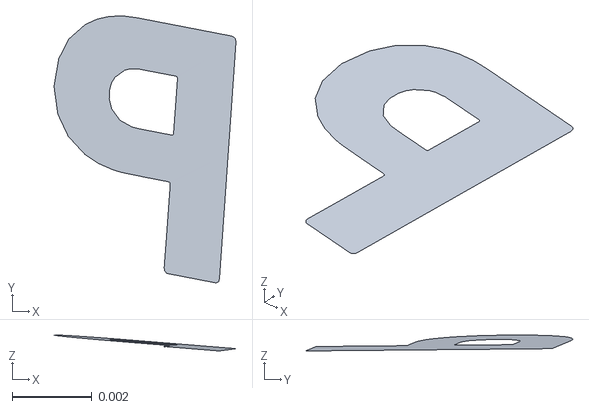
[picture p93: CAD file, 2026-05-08]
software/diy_pipeline/robot-assets-skills/robots/piper_arm/assets/link3_3.obj
0.00455 x 0.00668 x 0.000398
