PathOn-AI/PathOnRoboticsOSS/software/diy_pipeline/robot-assets-skills/robots/piper_arm/meshes/link3.STL

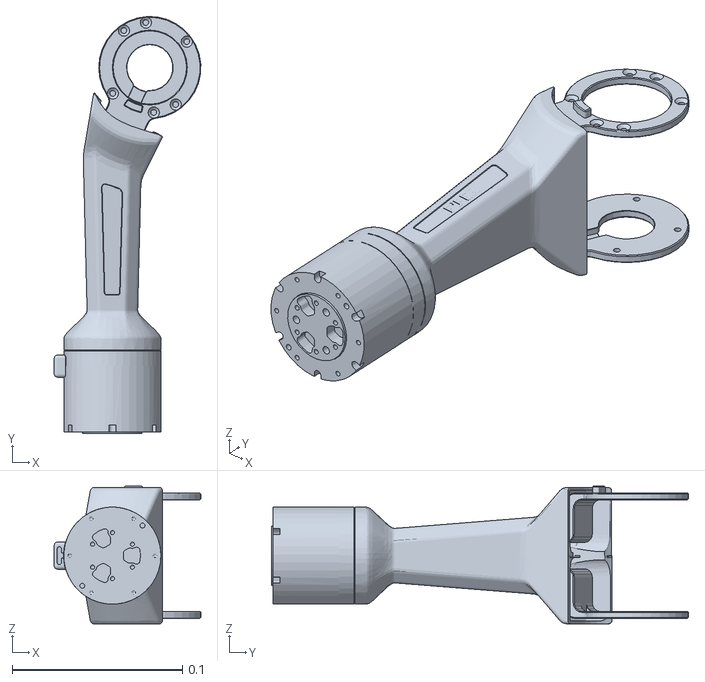
[picture p94: CAD file, 2026-05-08]
software/diy_pipeline/robot-assets-skills/robots/piper_arm/meshes/link3.STL
0.0861 x 0.245 x 0.0807
