PathOn-AI/PathOnRoboticsOSS/hardware/end_effectors/dexterous_hand/v3/cad/spur_gear_m2.00_z30_d6.0_b2.0.step

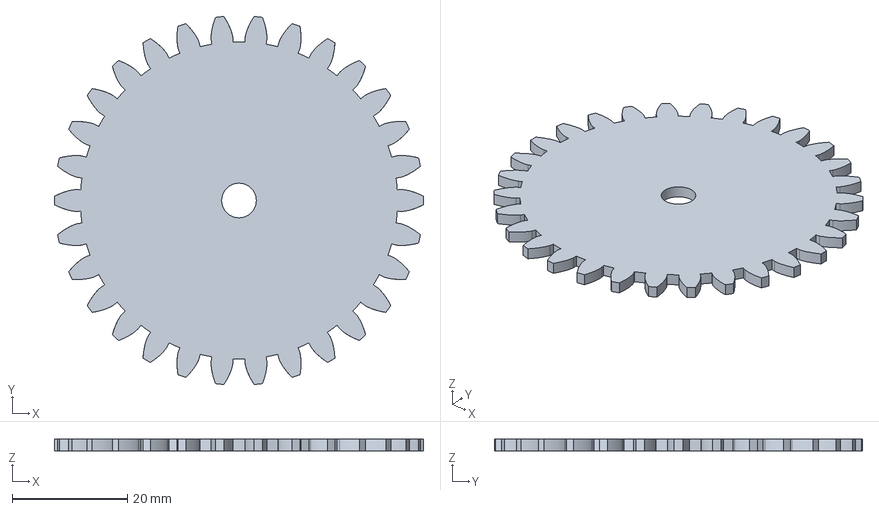
[picture p95: CAD file, 2026-08-09]
hardware/end_effectors/dexterous_hand/v3/cad/spur_gear_m2.00_z30_d6.0_b2.0.step
64.0 x 63.8 x 2.00 mm
