PathOn-AI/PathOnRoboticsOSS/hardware/end_effectors/dexterous_hand/v3/stl/mount_plate_with_waveshare_mount.stl

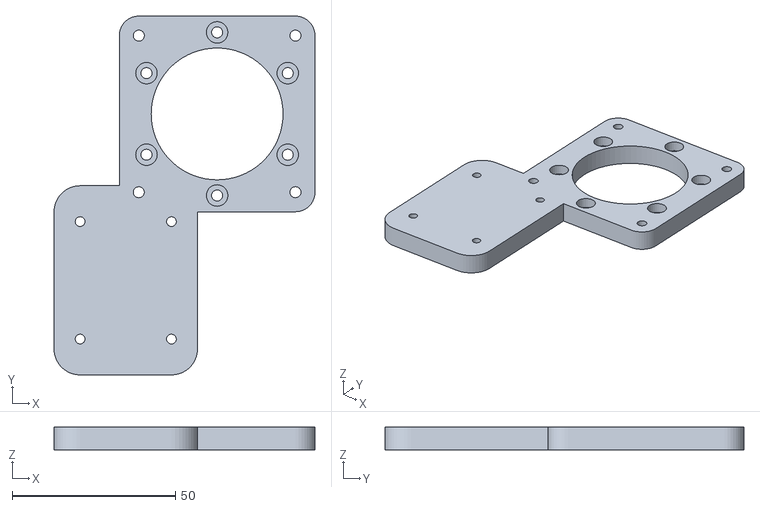
[picture p96: CAD file, 2026-11-03]
hardware/end_effectors/dexterous_hand/v3/stl/mount_plate_with_waveshare_mount.stl
80.0 x 110.0 x 7.00
