PathOn-AI/PathOnRoboticsOSS/hardware/end_effectors/symmetric_gripper/hardware/3d_printed_parts/symmetric_gripper/stl/cam.stl

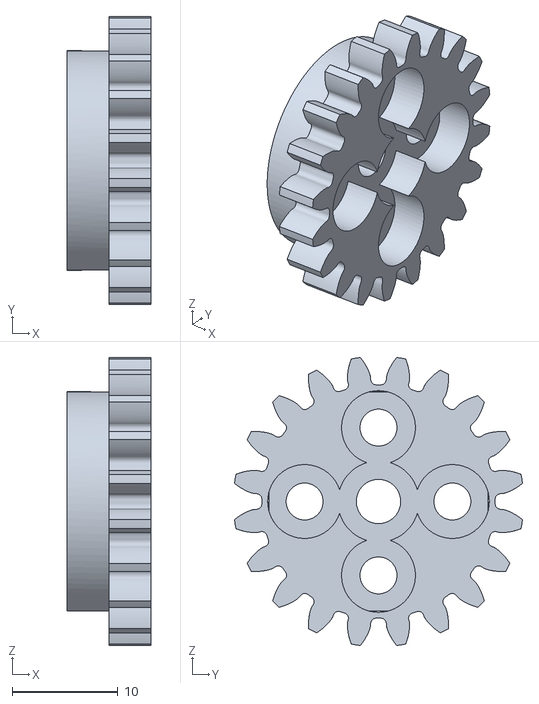
[picture p97: CAD file, 2026-04-14]
hardware/end_effectors/symmetric_gripper/hardware/3d_printed_parts/symmetric_gripper/stl/cam.stl
8.00 x 27.3 x 27.3
