PathOn-AI/PathOnRoboticsOSS/hardware/robots/piper_leader/stl/base.stl

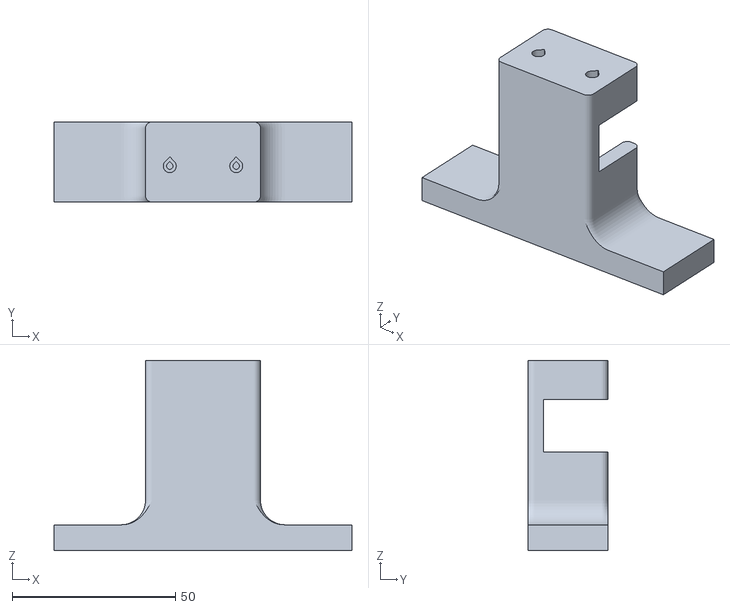
[picture p98: CAD file, 2026-07-14]
hardware/robots/piper_leader/stl/base.stl
91.2 x 24.5 x 58.2
