PathOn-AI/PathOnRoboticsOSS/hardware/so101_6dof_symmetric_gripper/software/robot_assets/meshes/link_pitch_1.stl

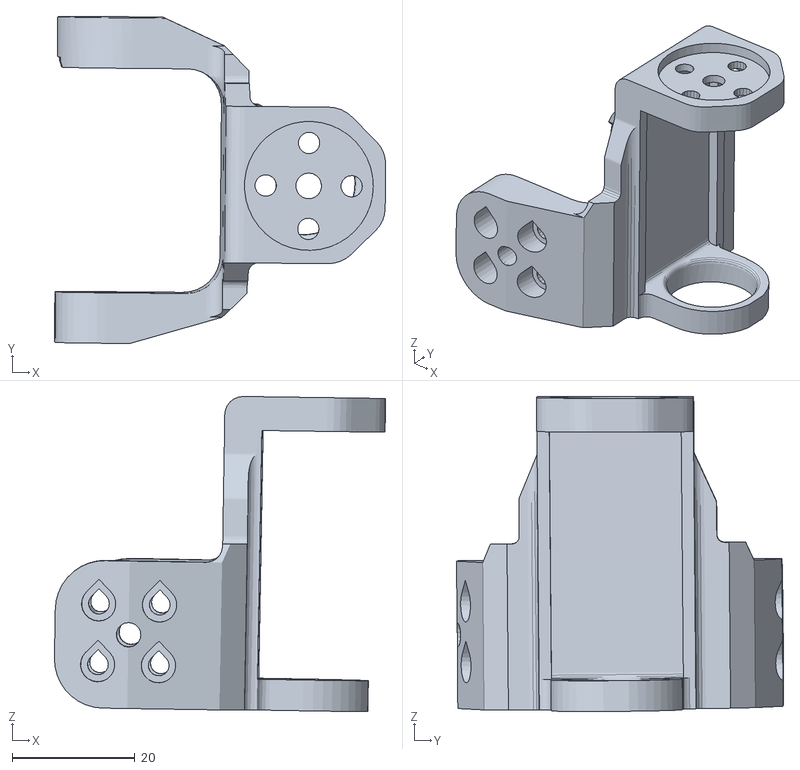
[picture p99: CAD file, 2026-04-14]
hardware/so101_6dof_symmetric_gripper/software/robot_assets/meshes/link_pitch_1.stl
53.9 x 53.3 x 51.3
