PathOn-AI/PathOnRoboticsOSS/software/diy_pipeline/robot-assets-skills/robots/piper_arm/assets/link2_31.obj

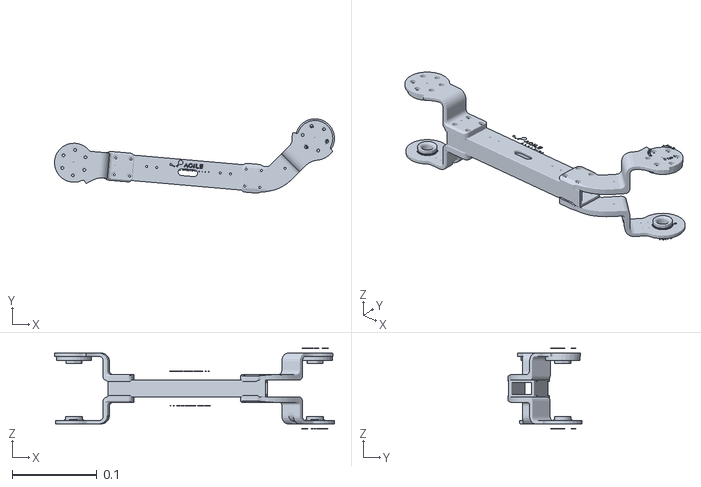
[picture p102: CAD file, 2026-05-08]
software/diy_pipeline/robot-assets-skills/robots/piper_arm/assets/link2_31.obj
0.329 x 0.0875 x 0.0946
