PathOn-AI/PathOnRoboticsOSS/software/diy_pipeline/robot-assets-skills/robots/piper_arm/meshes/base_link.STL

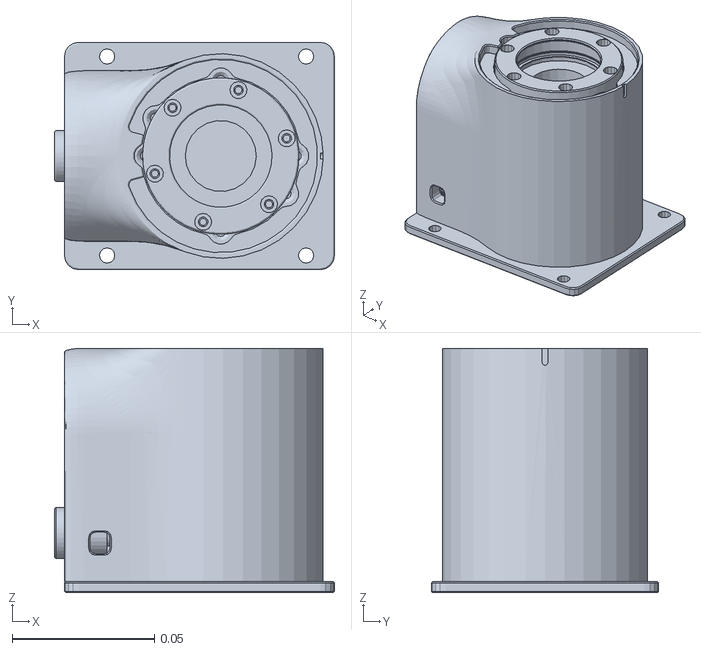
[picture p103: CAD file, 2026-05-08]
software/diy_pipeline/robot-assets-skills/robots/piper_arm/meshes/base_link.STL
0.0985 x 0.08 x 0.086
