PathOn-AI/PathOnRoboticsOSS/hardware/end_effectors/dexterous_hand/v3/cad/primal_link.SLDPRT

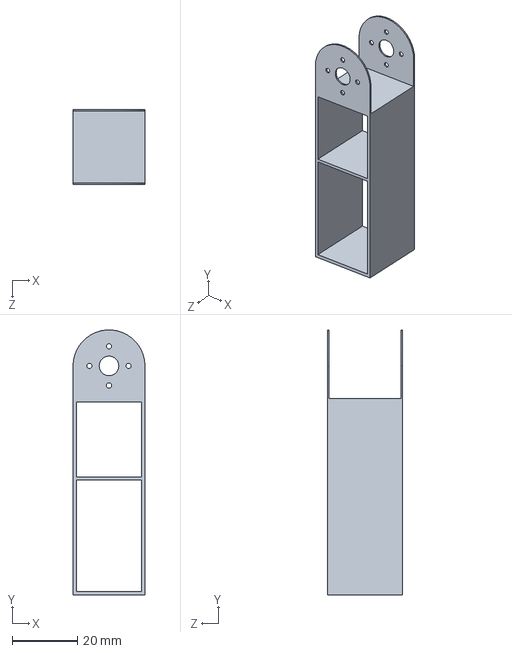
[picture p104: CAD file, 2026-08-09]
hardware/end_effectors/dexterous_hand/v3/cad/primal_link.SLDPRT
22.0 x 81.0 x 23.0 mm
