PathOn-AI/PathOnRoboticsOSS/hardware/end_effectors/dexterous_hand/v3/stl/thumb_mount.stl

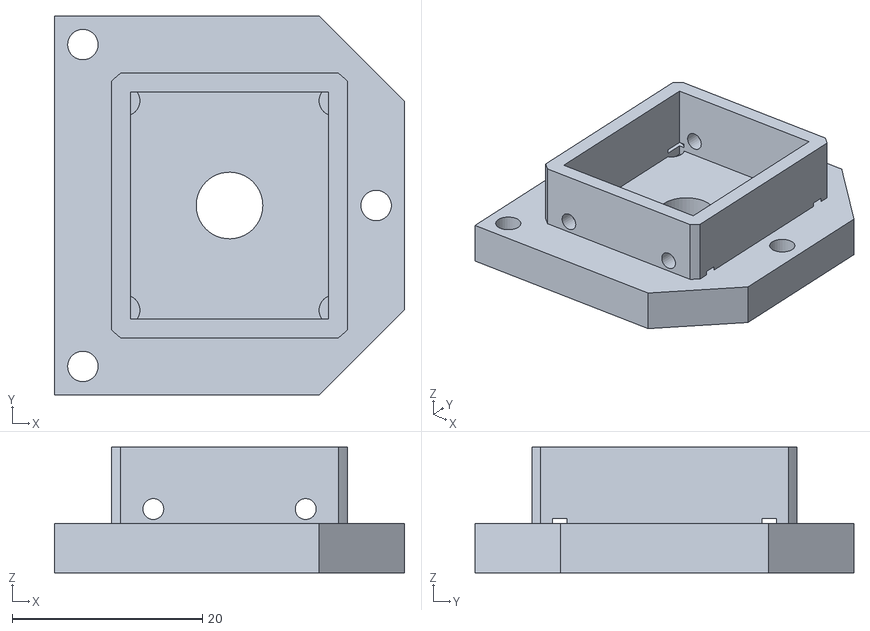
[picture p105: CAD file, 2026-11-03]
hardware/end_effectors/dexterous_hand/v3/stl/thumb_mount.stl
36.8 x 39.8 x 13.2
