PathOn-AI/PathOnRoboticsOSS/hardware/end_effectors/symmetric_gripper/hardware/3d_printed_parts/symmetric_gripper/stl/frame.stl

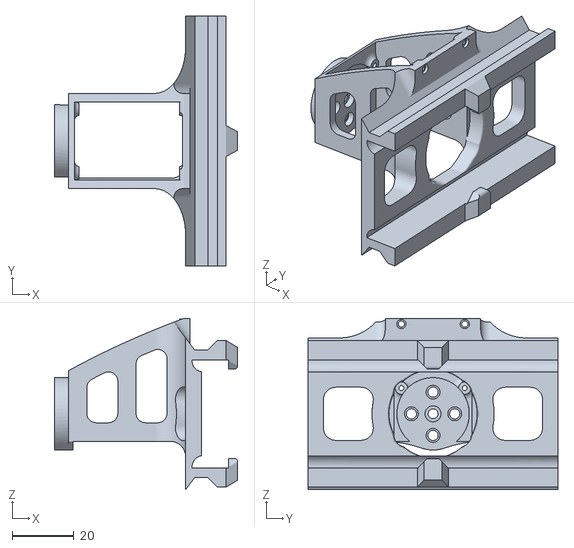
[picture p106: CAD file, 2026-04-14]
hardware/end_effectors/symmetric_gripper/hardware/3d_printed_parts/symmetric_gripper/stl/frame.stl
59.2 x 80.8 x 55.4
