PathOn-AI/PathOnRoboticsOSS/hardware/robots/piper_leader/stl/roll_1.stl

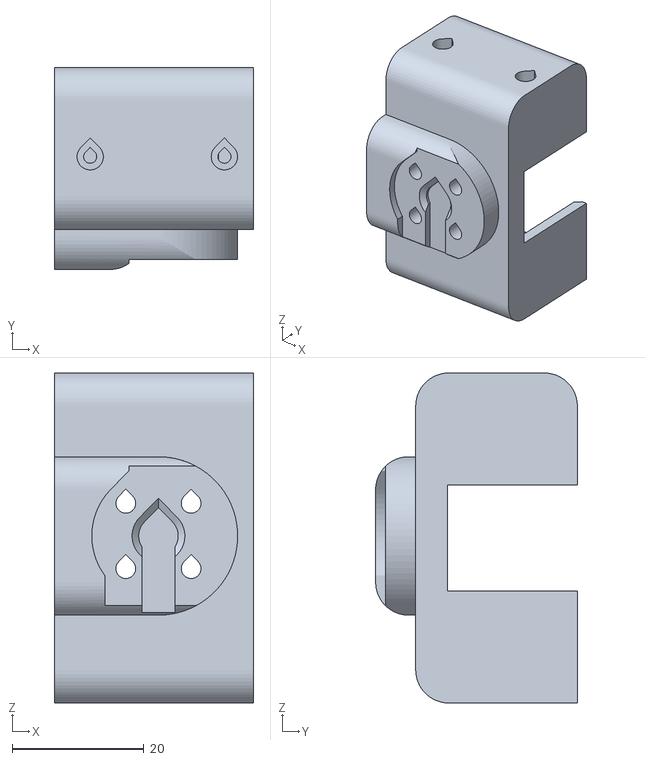
[picture p107: CAD file, 2026-07-14]
hardware/robots/piper_leader/stl/roll_1.stl
30.2 x 30.6 x 50.0
