PathOn-AI/PathOnRoboticsOSS/hardware/robots/so101_6dof_wrist/software/robot_assets/meshes/shoulder_link_1.stl

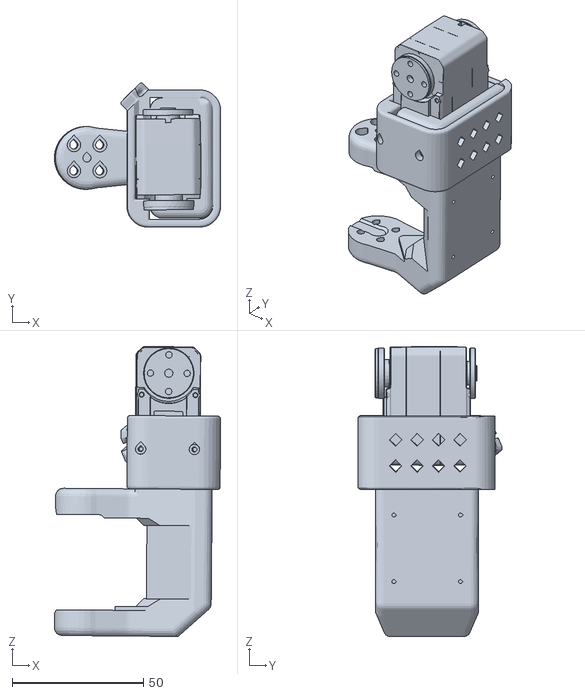
[picture p108: CAD file, 2026-04-14]
hardware/robots/so101_6dof_wrist/software/robot_assets/meshes/shoulder_link_1.stl
63.5 x 55.1 x 110.7
