PathOn-AI/PathOnRoboticsOSS/software/diy_pipeline/robot-assets-skills/robots/allegro_right/meshes/link_12.0_right.STL

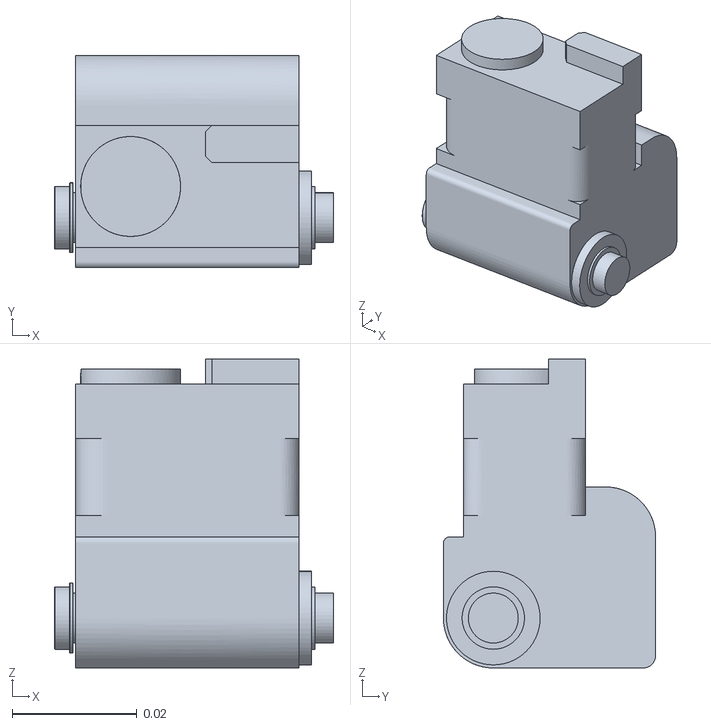
[picture p109: CAD file, 2026-05-08]
software/diy_pipeline/robot-assets-skills/robots/allegro_right/meshes/link_12.0_right.STL
0.0447 x 0.034 x 0.0495
