PathOn-AI/PathOnRoboticsOSS/software/diy_pipeline/robot-assets-skills/robots/piper_arm/assets/link3_10.obj

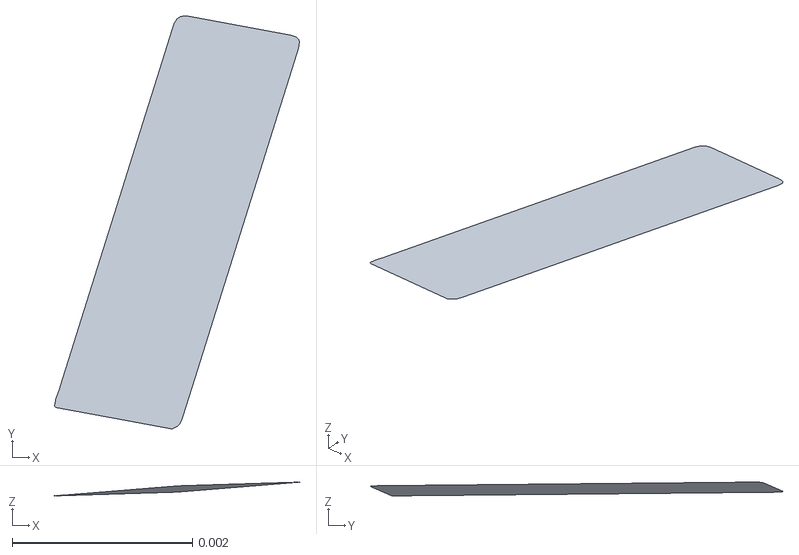
[picture p110: CAD file, 2026-05-08]
software/diy_pipeline/robot-assets-skills/robots/piper_arm/assets/link3_10.obj
0.00272 x 0.00458 x 0.000153
