PathOn-AI/PathOnRoboticsOSS/software/diy_pipeline/robot-assets-skills/robots/piper_arm/meshes/link2.STL

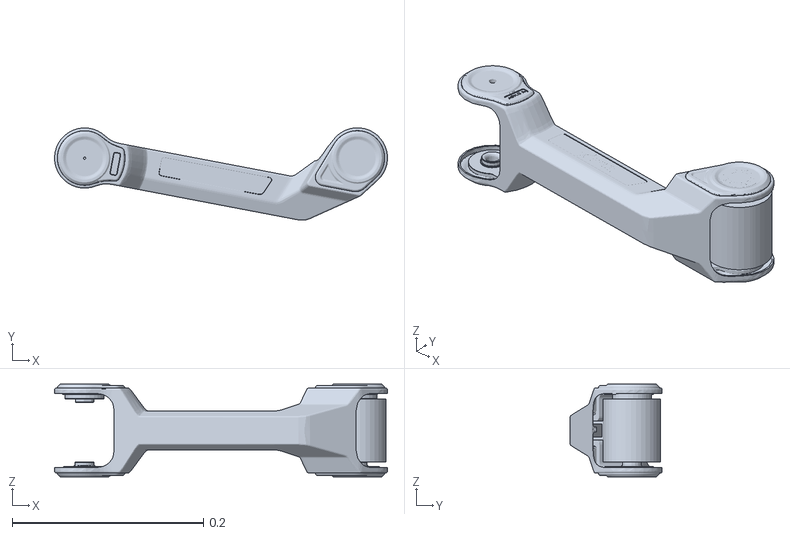
[picture p111: CAD file, 2026-05-08]
software/diy_pipeline/robot-assets-skills/robots/piper_arm/meshes/link2.STL
0.348 x 0.0965 x 0.097
