PathOn-AI/PathOnRoboticsOSS/hardware/end_effectors/dexterous_hand/v3/cad/base.SLDPRT

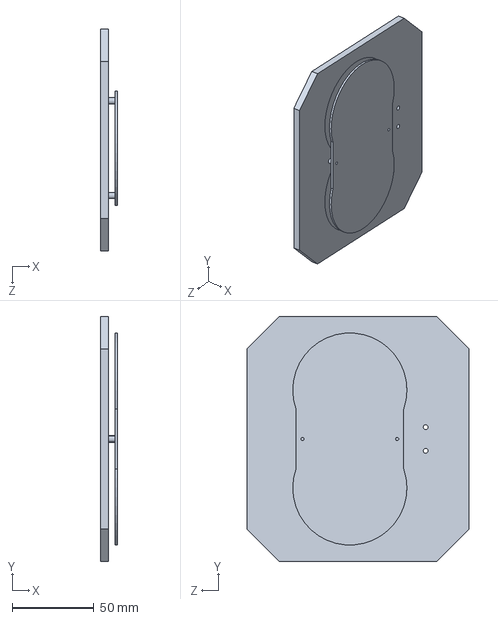
[picture p112: CAD file, 2026-08-09]
hardware/end_effectors/dexterous_hand/v3/cad/base.SLDPRT
10.5 x 150.2 x 136.2 mm
