PathOn-AI/PathOnRoboticsOSS/hardware/robots/piper_leader/stl/shoulder.stl

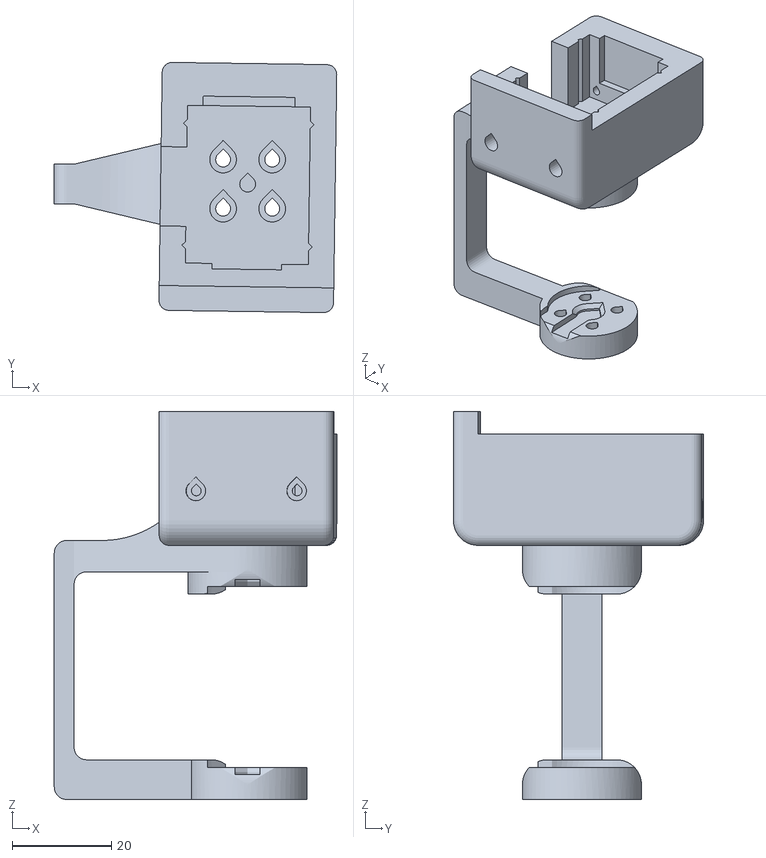
[picture p113: CAD file, 2026-07-14]
hardware/robots/piper_leader/stl/shoulder.stl
57.0 x 50.4 x 78.2
