PathOn-AI/PathOnRoboticsOSS/software/diy_pipeline/robot-assets-skills/robots/allegro_right/assets/link_2.0.stl

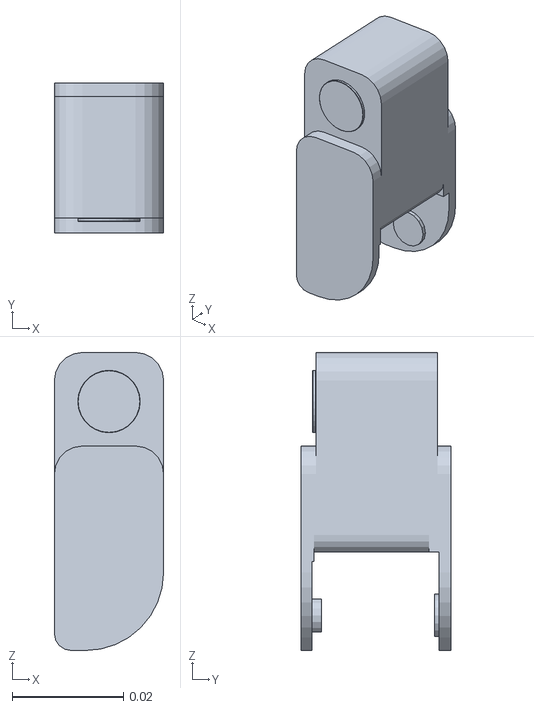
[picture p114: CAD file, 2026-05-08]
software/diy_pipeline/robot-assets-skills/robots/allegro_right/assets/link_2.0.stl
0.0196 x 0.027 x 0.0535
