PathOn-AI/PathOnRoboticsOSS/hardware/end_effectors/dexterous_hand/v3/cad/base_base.SLDPRT

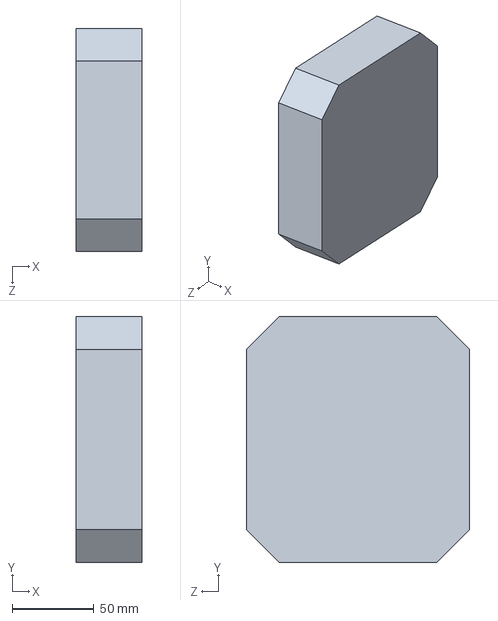
[picture p117: CAD file, 2026-08-09]
hardware/end_effectors/dexterous_hand/v3/cad/base_base.SLDPRT
40.0 x 150.2 x 136.2 mm
