PathOn-AI/PathOnRoboticsOSS/hardware/so101_6dof_symmetric_gripper/software/robot_assets/meshes/upper_arm_link_1.stl

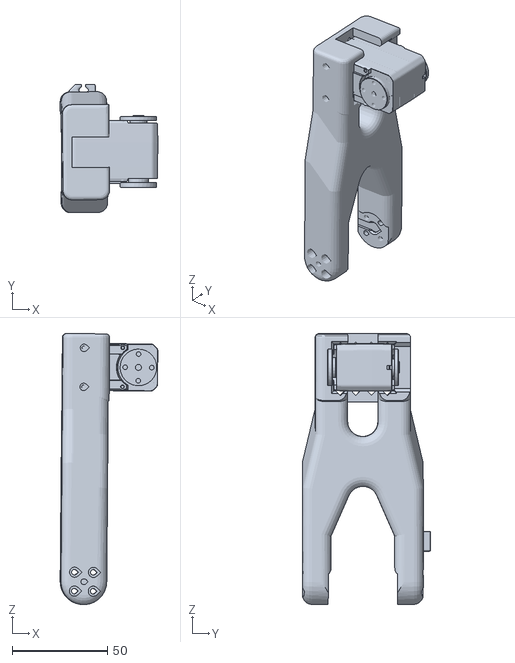
[picture p118: CAD file, 2026-04-14]
hardware/so101_6dof_symmetric_gripper/software/robot_assets/meshes/upper_arm_link_1.stl
51.3 x 67.4 x 142.2
