PathOn-AI/PathOnRoboticsOSS/software/diy_pipeline/robot-assets-skills/robots/allegro_right/meshes/link_15.0.STL

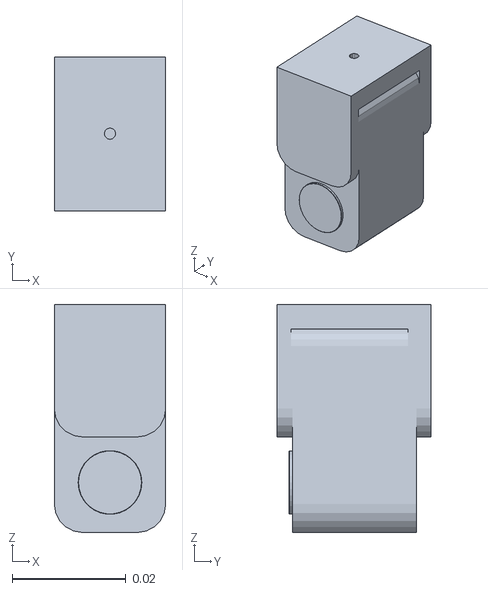
[picture p119: CAD file, 2026-05-08]
software/diy_pipeline/robot-assets-skills/robots/allegro_right/meshes/link_15.0.STL
0.0196 x 0.027 x 0.0401
