PathOn-AI/PathOnRoboticsOSS/hardware/end_effectors/dexterous_hand/v3/cad/Part14_onlycoupler^dex_hand.SLDPRT

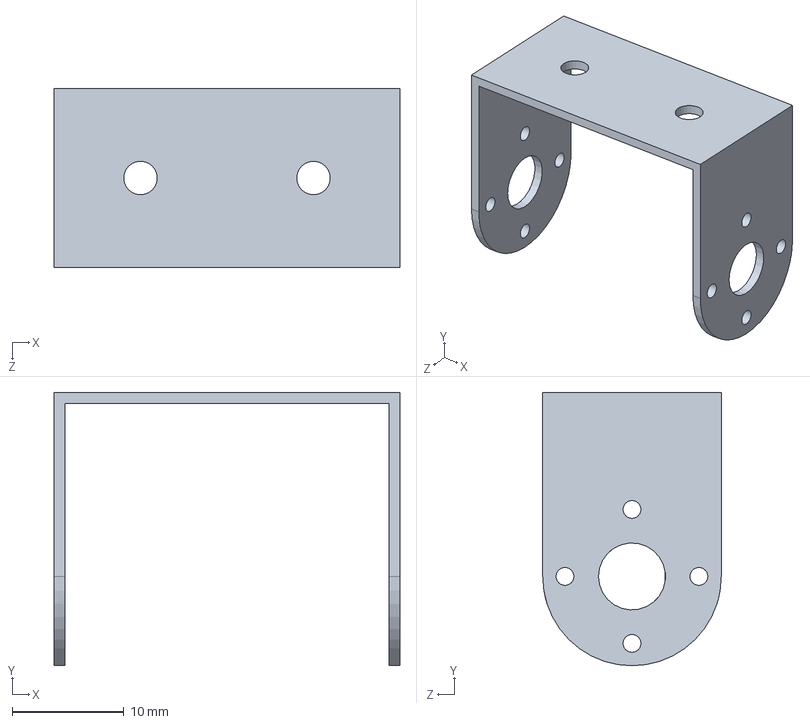
[picture p121: CAD file, 2026-08-09]
hardware/end_effectors/dexterous_hand/v3/cad/Part14_onlycoupler^dex_hand.SLDPRT
31.0 x 24.5 x 16.0 mm
