PathOn-AI/PathOnRoboticsOSS/software/diy_pipeline/robot-assets-skills/robots/allegro_right/meshes/link_15.0_tip.STL

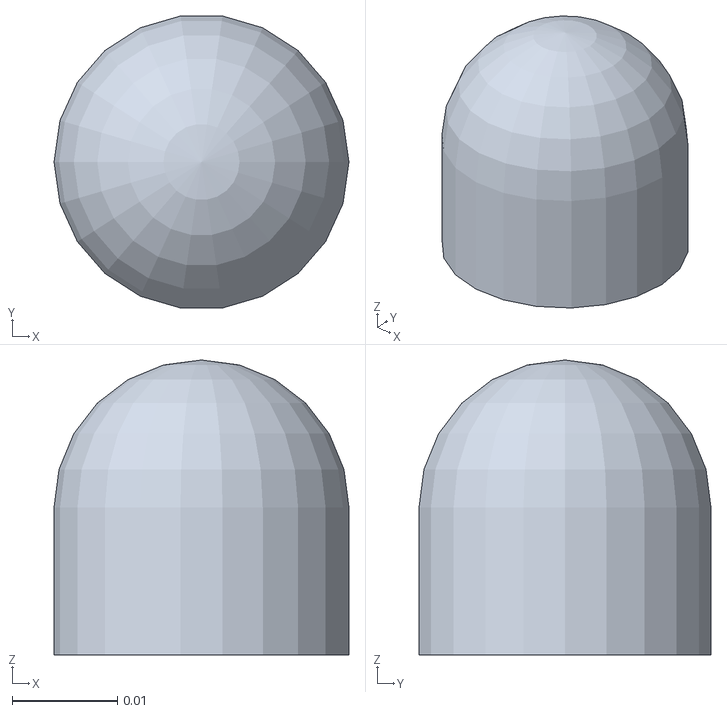
[picture p122: CAD file, 2026-05-08]
software/diy_pipeline/robot-assets-skills/robots/allegro_right/meshes/link_15.0_tip.STL
0.028 x 0.0277 x 0.028
