PathOn-AI/PathOnRoboticsOSS/software/diy_pipeline/robot-assets-skills/robots/allegro_right/assets/link_3.0_tip.stl

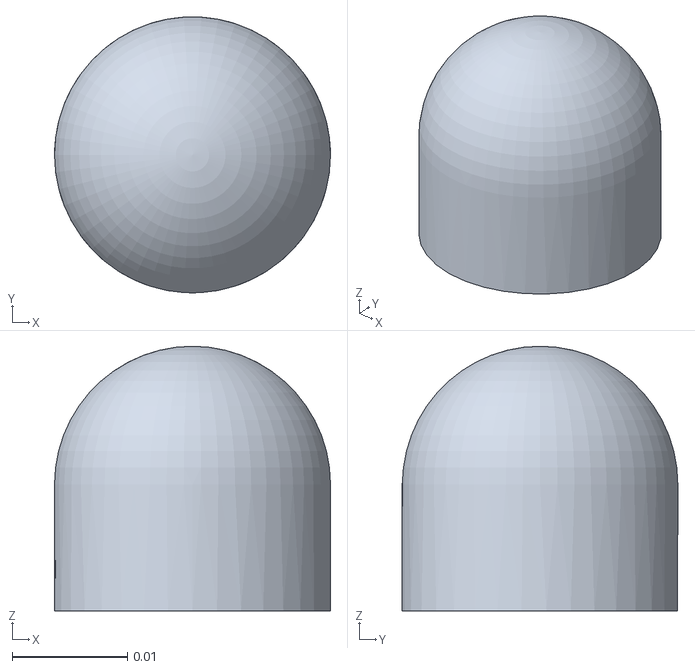
[picture p125: CAD file, 2026-05-08]
software/diy_pipeline/robot-assets-skills/robots/allegro_right/assets/link_3.0_tip.stl
0.024 x 0.024 x 0.023
