PathOn-AI/PathOnRoboticsOSS/software/diy_pipeline/robot-assets-skills/robots/allegro_right/assets/link_12.0_left.stl

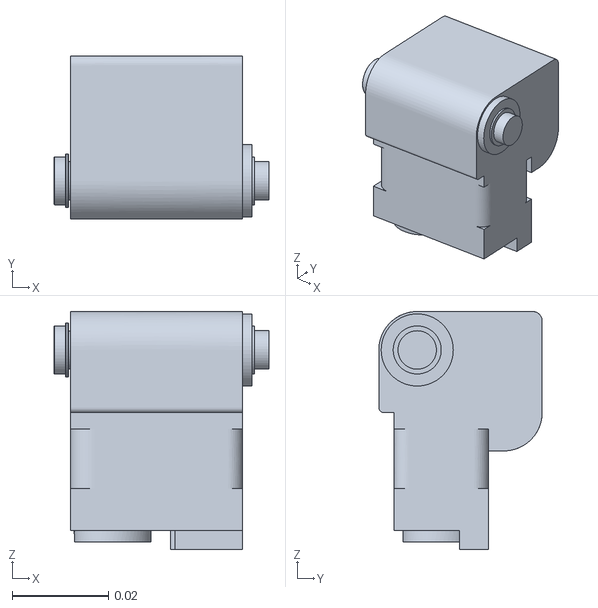
[picture p130: CAD file, 2026-05-08]
software/diy_pipeline/robot-assets-skills/robots/allegro_right/assets/link_12.0_left.stl
0.0447 x 0.034 x 0.0495
