PathOn-AI/PathOnRoboticsOSS/software/diy_pipeline/robot-assets-skills/robots/piper_arm/assets/linke2_dark_gray.stl

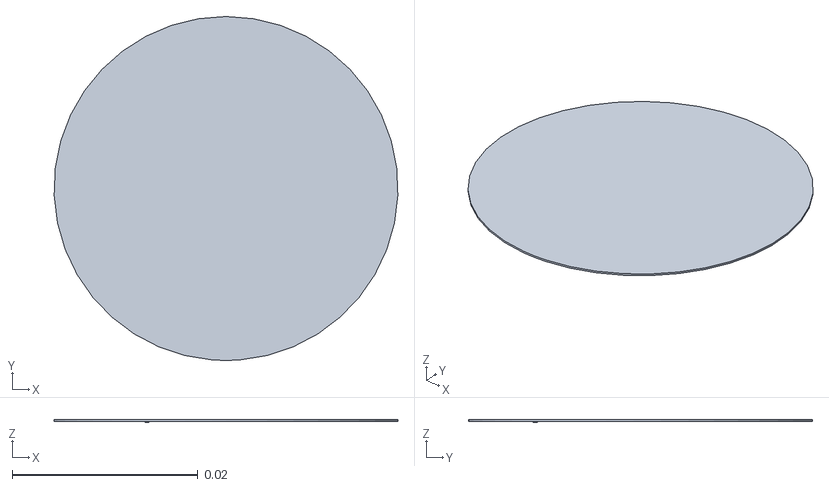
[picture p136: CAD file, 2026-05-08]
software/diy_pipeline/robot-assets-skills/robots/piper_arm/assets/linke2_dark_gray.stl
0.037 x 0.037 x 0.000299
