PathOn-AI/PathOnRoboticsOSS/hardware/end_effectors/dexterous_hand/v3/cad/dex_hand.SLDASM

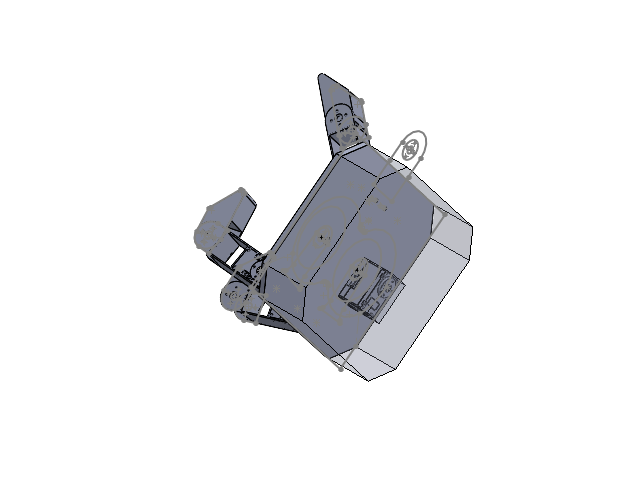
[picture p165: CAD file, 2026-08-09]
hardware/end_effectors/dexterous_hand/v3/cad/dex_hand.SLDASM
XL,XC-330 x 4
Part16_straight^dex_hand x 2
spur_gear_m2.00_z30_d6.0_b2.0.step x 2
Part14_onlycoupler^dex_hand
base
base_base
primal_link x 3
distal x 3
Part17^dex_hand
