PathOn-AI/PathOnRoboticsOSS/(list of files, cad)

Other CAD files:
software/iphone_sensor_suite/Scanner3D/example_scan/2026-03-23--19-45-00/capture_000000/pointcloud.ply
software/iphone_sensor_suite/Scanner3D/example_scan/2026-03-23--19-45-00/capture_000001/pointcloud.ply
software/iphone_sensor_suite/Scanner3D/example_scan/2026-03-23--19-45-00/capture_000002/pointcloud.ply
software/iphone_sensor_suite/Scanner3D/example_scan/2026-03-23--19-45-00/capture_000003/pointcloud.ply
software/iphone_sensor_suite/Scanner3D/example_scan/2026-03-23--19-45-00/capture_000004/pointcloud.ply
hardware/end_effectors/symmetric_gripper/hardware/3d_printed_parts/symmetric_gripper/stl/r_gripper.stl
software/diy_pipeline/robot-assets-skills/robots/allegro_right/meshes/base_link.STL
software/diy_pipeline/robot-assets-skills/robots/allegro_right/assets/base_link.stl
software/diy_pipeline/robot-assets-skills/robots/allegro_right/meshes/link_13.0.STL
hardware/end_effectors/symmetric_gripper/hardware/3d_printed_parts/symmetric_gripper/stl/rack_down.stl
software/diy_pipeline/robot-assets-skills/robots/allegro_right/assets/link_13.0.stl
hardware/end_effectors/dexterous_hand/v3/cad/Part17.SLDPRT
hardware/robots/so101_6dof_wrist/software/robot_assets/meshes/left_jaw_v1_1.stl
hardware/so101_6dof_symmetric_gripper/software/robot_assets/meshes/left_jaw_v1_1.stl
software/diy_pipeline/robot-assets-skills/robots/allegro_right/assets/link_4.0.stl
software/diy_pipeline/robot-assets-skills/robots/allegro_right/assets/link_15.0_tip.stl
software/diy_pipeline/robot-assets-skills/robots/piper_arm/assets/link2_15.obj
software/diy_pipeline/robot-assets-skills/robots/piper_arm/assets/link3_11.obj
software/diy_pipeline/robot-assets-skills/robots/piper_arm/assets/link2_12.obj
software/diy_pipeline/robot-assets-skills/robots/piper_arm/assets/link3_26.obj
software/diy_pipeline/robot-assets-skills/robots/piper_arm/assets/link3_0.obj
software/diy_pipeline/robot-assets-skills/robots/piper_arm/assets/link2_16.obj
software/diy_pipeline/robot-assets-skills/robots/piper_arm/assets/link3_25.obj
software/diy_pipeline/robot-assets-skills/robots/piper_arm/assets/link2_6.obj
software/diy_pipeline/robot-assets-skills/robots/piper_arm/assets/link2_14.obj
hardware/end_effectors/dexterous_hand/v1/3mf/Dex_hand.3mf
hardware/end_effectors/dexterous_hand/v1/cad/pathon_dex_hand.step
hardware/end_effectors/dexterous_hand/v1/stl/11.stl
hardware/end_effectors/dexterous_hand/v1/stl/12.stl
hardware/end_effectors/dexterous_hand/v1/stl/21.stl
hardware/end_effectors/dexterous_hand/v1/stl/22.stl
hardware/end_effectors/dexterous_hand/v1/stl/Body17.stl
hardware/end_effectors/dexterous_hand/v1/stl/palm.stl
hardware/end_effectors/dexterous_hand/v1/stl/th_1.stl
hardware/end_effectors/dexterous_hand/v1/stl/th_2.stl
hardware/end_effectors/dexterous_hand/v1/stl/th_3.stl
hardware/end_effectors/dexterous_hand/v2/3mf/dex3_hand_v2.3mf
hardware/end_effectors/dexterous_hand/v2/stl/Feetech SCS0009 v9.stl
hardware/end_effectors/dexterous_hand/v2/stl/Finger.stl
hardware/end_effectors/dexterous_hand/v2/stl/MirroredFinger.stl
hardware/end_effectors/dexterous_hand/v2/stl/Mountfemale.stl
hardware/end_effectors/dexterous_hand/v2/stl/Mountmale.stl
hardware/end_effectors/dexterous_hand/v2/stl/Palm.stl
hardware/end_effectors/dexterous_hand/v2/stl/Palm_mount.stl
hardware/end_effectors/dexterous_hand/v3/cad/XL,XC-330.SLDASM
hardware/end_effectors/dexterous_hand/v3/cad/XL,XC-330.SLDPRT
hardware/end_effectors/dexterous_hand/v3/stl/Part16_straight^dex_hand.STL
hardware/end_effectors/dexterous_hand/v3/stl/base.STL
hardware/end_effectors/dexterous_hand/v3/stl/base_base.STL
hardware/end_effectors/dexterous_hand/v3/stl/distal.STL
hardware/end_effectors/dexterous_hand/v3/stl/primal_link.STL
hardware/robots/openarm_leader/cad_files/stl/j5.stl
hardware/robots/piper_leader/stl/lower_arm.stl
hardware/robots/so101_6dof_wrist/hardware/3d_printed_parts/6dof/stl/link_pitch.stl
hardware/so101_6dof_symmetric_gripper/hardware/3d_printed_parts/6dof/stl/link_pitch.stl
software/diy_pipeline/robot-assets-skills/robots/piper_arm/assets/link2.stl
software/diy_pipeline/robot-assets-skills/robots/piper_arm/assets/link2_13.obj
software/diy_pipeline/robot-assets-skills/robots/piper_arm/assets/link2_18.obj
software/diy_pipeline/robot-assets-skills/robots/piper_arm/assets/link2_19.obj
software/diy_pipeline/robot-assets-skills/robots/piper_arm/assets/link2_21.obj
software/diy_pipeline/robot-assets-skills/robots/piper_arm/assets/link2_26.obj
software/diy_pipeline/robot-assets-skills/robots/piper_arm/assets/link2_27.obj
software/diy_pipeline/robot-assets-skills/robots/piper_arm/assets/link2_3.obj
software/diy_pipeline/robot-assets-skills/robots/piper_arm/assets/link2_30.obj
software/diy_pipeline/robot-assets-skills/robots/piper_arm/assets/link2_5.obj
software/diy_pipeline/robot-assets-skills/robots/piper_arm/assets/link2_gray.stl
software/diy_pipeline/robot-assets-skills/robots/piper_arm/assets/link3.stl
software/diy_pipeline/robot-assets-skills/robots/piper_arm/assets/link3_1.obj
software/diy_pipeline/robot-assets-skills/robots/piper_arm/assets/link3_14.obj
software/diy_pipeline/robot-assets-skills/robots/piper_arm/assets/link3_19.obj
software/diy_pipeline/robot-assets-skills/robots/piper_arm/assets/link3_2.obj
software/diy_pipeline/robot-assets-skills/robots/piper_arm/assets/link3_21.obj
software/diy_pipeline/robot-assets-skills/robots/piper_arm/assets/link3_22.obj
software/diy_pipeline/robot-assets-skills/robots/piper_arm/assets/link3_27.obj
software/diy_pipeline/robot-assets-skills/robots/piper_arm/assets/link4_2.obj
software/diy_pipeline/robot-assets-skills/robots/piper_arm/assets/link4_4.obj
software/diy_pipeline/robot-assets-skills/robots/piper_arm/assets/link5.stl
software/diy_pipeline/robot-assets-skills/robots/piper_arm/assets/link5_2.obj
software/diy_pipeline/robot-assets-skills/robots/piper_arm/assets/link5_5.obj
software/diy_pipeline/robot-assets-skills/robots/piper_arm/assets/link5_7.obj
software/diy_pipeline/robot-assets-skills/robots/piper_arm/assets/link5_8.obj
