PathOn-AI/PathOnRoboticsOSS/(commit log)

2026-04-14 Update 3D printed parts and remove duplicate CAD files from Documentation
    [cam.step, cam.stl, frame.step, frame.stl, link_pitch.step, link_pitch.stl, link_yaw.step, rack_down.step]
2026-04-14 Add URDF, MJCF, and meshes for SO-101 6DoF symmetric gripper
    Fix URDF transmission names to match actual joint names
    (Revolute_1-6, left/right_jaw_slider).
    [base_link.stl, left_jaw_v1_1.stl, link_pitch_1.stl, link_roll_v1_1.stl, link_yaw_v1_1.stl, lower_arm_link_1.stl, right_jaw_v1_1.stl, shoulder_link_1.stl]
2026-04-15 refactor: reorganize iphone_sensor_suite into per-app folders
    - Move sdk/, ros2-driver/, calibration/ into Record3DStream/
    - Create Scanner3D/ with README and privacy policy
    - Update top-level README to introduce both apps
2026-04-15 feat: add Scanner3D pipeline and example scan data
    - Add 4-step processing pipeline: calibrate_3d, generate_pcds, fuse_pointclouds, transform_pointcloud
    - Add example scan (2026-03-23--19-45-00) with 5 captures for testing
    [pointcloud.ply]
2026-04-15 refactor: simplify Scanner3D pipeline to 3 steps
    - Remove generate_pcds.py (not needed for TSDF fusion)
    - Update README with 3-step pipeline: calibrate → fuse → transform
    - Add example commands using example_scan data
2026-04-15 feat: add Tools landing page and update nav links
    Add a Tools index page listing available tools. Update nav links in
    header and mobile menu to point to /tools instead of directly to the
    point cloud viewer.
2026-04-17 docs: add real-robot VLG demo and backfill news entries
    Split real-robot demos into MoveIt and Vision-Language Grasping sections,
    added new Loom for real-robot VLG, and backfilled news entries for BOM,
    assembly guide, and URDF/MJCF releases.
2026-04-18 feat: add 3D Gaussian Splatting viewer tool
    New /tools/3dgs-viewer page accepts a .ply / .spz / .splat / .ksplat file
    and renders it in-browser via @sparkjsdev/spark 2.0 + @react-three/fiber.
    Drag-drop + click-to-upload, full-viewport canvas, camera auto-fits to the
    splat bbox, RGB axes and infinite grid at origin, clickable orientation
    gizmo (top-right), and a "Fit to scene" button for re-framing.
    Spark 2.0 peer-deps three ^0.180 and this repo pins ^0.183, so the package
    is installed with --legacy-peer-deps; tested working end-to-end at 3k and
    30k step splatfacto exports.
2026-04-18 fix: 3DGS viewer auto-framing and add transform panel
    Auto-fit now uses median center + 90th-percentile radius so a handful of
    outlier splats don't blow the bounding box out (closes
    PathOn-AI/opensource_record3d#33 — splat7.ply rendered as a tiny
    starburst because outliers pushed the camera ~26 units away from the
    ~1 unit cluster).
    Also adds a Position / Rotation / Scale panel wired through a parent
    group so user transforms compose cleanly with the auto-fit centering.
2026-04-18 chore: move calibration images to shared images folder
2026-04-29 refactor(iphone-driver): delegate /scan to pointcloud_to_laserscan
    Replace the in-node middle-row LaserScan with the standard
    pointcloud_to_laserscan node fed by the existing depth pointcloud.
    - iphone_sensor_node.py: drop publish_scan parameter, the laser
    frame static TF, and the _make_laserscan helper (~80 lines).
    - iphone_sensor.launch.py: launch pointcloud_to_laserscan with
    configurable target_frame, height band, range, and angle window;
    expose usb:= launch arg passthrough.
    - package.xml: add pointcloud_to_laserscan as exec_depend.
    Why: the middle-row scan only sees obstacles at one pixel height and
    tilts with the camera, which is poor input for slam_toolbox / Nav2.
    pointcloud_to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
2026-04-30 feat(iphone-driver): add publish_scan launch toggle and refresh docs
    - launch: add publish_scan arg (default true) gating pointcloud_to_laserscan via IfCondition
    - launch: change default scan_target_frame from base_link to camera_link
    - docs: switch Running section to ros2 run after sourcing install/setup.bash; drop redundant pip install -e .
    - docs: add Demo section linking 2D-navigation Loom video
    - docs: sync Parameters table with current node (add usb, publish_scan launch-arg; drop stale publish_scan node-param row)
    - docs: correct /scan rate (~6fps via pointcloud_to_laserscan)
2026-04-30 docs: streamline parent README to point at subfolder docs
    Move the demo video to the parent README and drop the duplicated
    Python/ROS2/calibration command blocks plus the topics/parameters
    tables; the parent now points to each component's own README. Polish
    sdk/README.md install instructions and example list to match.
2026-04-30 docs: add news entry for 2D SLAM demo and pointcloud_to_laserscan switch
2026-04-30 docs: note iPhone must be held vertical for 2D SLAM scan slicing
    The default pointcloud_to_laserscan setup slices in the body-fixed
    camera_link frame, so the phone's vertical axis must align with
    gravity for the scan plane to stay horizontal. Mention base_link as
    the tilt-tolerant target_frame for robot-mounted setups.
2026-05-06 feat(robot-assets-skills): add skill bundle for arm + end-effector workflows
    `AGENTS.md`-pattern skill bundle for Claude Code / Codex working on
    robot MJCF/URDF assets. Ships:
    - `attach-end-effector` — combine an arm + end-effector MJCF via
    MuJoCo's MjSpec API. Wraps `attach_arm_gripper.py` with a preflight
    checklist and post-script fixes for the four known silent-failure
    modes (mesh-filename collisions, palm-origin offsets, empty-prefix
    failures, and the script's `<compiler meshdir>` blind spot).
    - `urdf-to-mjcf`, `mjcf-to-urdf` — planned stubs.
    User-populated dirs (`robots/`, `.venv/`) stay gitignored.
2026-05-06 chore(iphone-sensor-suite): gitignore colcon build/install/log dirs
    Stops `git status` from listing colcon's build/install/log triple
    under `Record3DStream/` (and any future ROS2 packages added beside it).
2026-05-06 feat(livox-mid360-go2-mount): add 3D-printable Mid-360 LiDAR mount for Unitree Go2
    Cantilever bracket that holds a Livox Mid-360 forward of the Go2's head
    for unobstructed 360 deg FOV. Mates with the T-track base plate from
    Printables (linked in README).
    [livox_mid360_mount.stl]
2026-05-07 docs(readme): credit PathOnAI.org as joint contributor
2026-05-08 feat(robot-assets-skills): ship example arm + hand inputs and refine attach-end-effector workflow
    Track piper_arm/ and allegro_right/ as ready-to-use example inputs (gitignore now whitelists these two under robots/), add the wrapped attach_arm_end_effector.py + compute_wrist_offset.py helper to the skill, and rewrite the attach-end-effector / mjcf-to-urdf / urdf-to-mjcf docs around the actual gotchas hit in practice (mesh-filename collisions, palm-origin offset on the wrist flange, empty-prefix failure modes, eef meshdir not under assets/).
    [allegro_right.urdf, base_link.STL, base_link.stl, base_link_left.stl, link1.STL, link1.stl, link2.STL, link2.stl]
2026-05-08 feat(robot-assets-skills): make wrist-mount helper arm-aware and auto-detect orientation
    Renames compute_wrist_offset.py to compute_wrist_mount.py and extends it to take both arm and eef MJCFs so it can express pos+quat in the actual wrist body frame. The previous output assumed identity site quat, which silently mounted hands in the wrong direction whenever the arm's attachment_site had a non-trivial quat (e.g. SO101's +90° around Y).
    The helper now also auto-detects the eef's "fingers-out" axis from the centroid of root-body descendants (handles ±X/±Y/±Z), exposes --twist for the under-determined rotation around that axis, and --h-override for the multi-geom case where the auto-pick (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
2026-05-08 docs(robot-assets-skills): add attach-end-effector Loom demo
    Show the skill mounting the Barrett 3-finger hand on the SO-101 6DoF arm so users can see the workflow before invoking it.
2026-05-12 Add URDF to MJCF skill wrapper
2026-05-12 feat(dexterous-hand): add 3-finger XL330-based dexterous hand
    3-finger, servo-actuated dexterous hand built around 7× DYNAMIXEL
    XL330-M288-T. Includes STEP assembly, printable STLs, Bambu Studio
    3MF print project, render/print-layout images, and README with specs,
    software pointers, and printing notes.
    [11.stl, 12.stl, 21.stl, 22.stl, Body17.stl, Dex_hand.3mf, palm.stl, pathon_dex_hand.step]
2026-06-12 refactor(dexterous-hand): move existing files into v1 subfolder
    [11.stl, 12.stl, 21.stl, 22.stl, Body17.stl, Dex_hand.3mf, palm.stl, pathon_dex_hand.step]
2026-06-16 Add dexterous hand V2 hardware files
    Feetech SCS0009-based 3-finger dexterous hand: STLs, Bambu Studio 3MF
    print project, media, and README. Mirrors the v1 package layout.
    [Feetech SCS0009 v9.stl, Finger.stl, MirroredFinger.stl, Mountfemale.stl, Mountmale.stl, Palm.stl, Palm_mount.stl, dex3_hand_v2.3mf]
2026-07-14 feat(piper_leader): add 6-DOF Feetech SCS215 leader arm (#33)
    * feat(k1): add K1 robot 3D-printable hardware kit
    Frame STLs (main shells, side brackets, beam, top/handle parts),
    accessory mounts (LiDAR, Raspberry Pi, battery), and printable
    shoes, plus front/back/isometric renders and a README with file
    layout and print settings.
    * revert(k1): remove K1 — belongs in private pathon_hardware repo, not opensource
    * feat(piper_leader): add 6-DOF Feetech SCS215 leader arm
    3D-printable leader arm for teleoperation. Includes the STEP assembly,
    seven print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
    [base.stl, lower_arm.stl, piper_leader.step, pitch.stl, roll_1.stl, roll_2.stl, shoulder.stl, upper_arm.stl]
2026-07-15 docs(diy_pipeline): initial release of agentic DIY robot pipeline design
    Architecture and validated results from the Jan-May 2026 pipeline work:
    text -> CAD -> URDF/MJCF -> end-effector attach -> ROS 2. Agent skills and
    demo videos to follow.
2026-07-22 docs: reorganize README into hardware/software tables; nest robot-assets-skills under diy_pipeline
    - Split Projects into Hardware and Software tables
    - Add missing entries: Piper Leader Arm, Dexterous Hand, DIY Pipeline
    - Move robot-assets-skills/ into diy_pipeline/ as the end-effector stage
    - Fix relative links in diy_pipeline/README.md
    - Reclassify iPhone Sensor Suite as a software project
    [allegro_right.urdf, base_link.STL, base_link.stl, base_link_left.stl, link1.STL, link1.stl, link2.STL, link2.stl]
2026-07-22 refactor: split projects into hardware/ and software/ folders
    - Move so101, piper_leader, dexterous_hand, livox_mid360_go2_mount into hardware/
    - Move diy_pipeline (with robot-assets-skills) and iphone_sensor_suite into software/
    - Update root README links to new paths
    - Fix website iphone_sensor_suite GitHub link to software/ path
    - website/ left at repo root
    [11.stl, 12.stl, 21.stl, 22.stl, Body17.stl, Dex_hand.3mf, Feetech SCS0009 v9.stl, Finger.stl]
2026-08-07 feat(website): feature Pathon hardware; split robots from mounts
    Our own hardware is now the front of the site: seven entries for the
    dexterous hands (V1/V2/V3), the SO-101 6DoF arm upgrade, the symmetric
    gripper, the Piper leader arm, and the Livox Mid-360 Go2 mount — sorted
    first, badged, and given a "Built by Pathon Robotics" section on the
    homepage.
    Entries now carry a `kind`, splitting actuated machines (robots) from
    passive printed hardware (mounts and adapters), plus a `maker` so
    community platforms read "by Hiwonder", "by AgileX", and so on. The
    robots page gets kind tabs, a "Built by Pathon" filter, and a short
    explainer of what each bucket means.
    Also fixes the homepage categor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
2026-08-07 refactor(website): fold tools into a Software page; Hardware/Software nav
    Tools and Software sat side by side in the nav, but a browser viewer is
    software too — the split that matters to a visitor is "runs here" vs
    "clone it". Both now live on /software: browser tools first, since they
    pay off with no install, then the projects.
    /tools redirects to /software; the viewers keep their /tools/* URLs so
    existing links stay good.
    The projects list claimed three repositories. There is one repo with two
    folders under software/ — Robot Assets Skills is the end-effector attach
    stage nested inside diy_pipeline, so it renders nested, as in the README.
    Header is Home / Hardware / Software; the har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
2026-08-07 feat(website): videos and posts on entry pages
    Each entry can carry a `media:` list in its frontmatter; the platform is
    read off the URL. Loom and YouTube embed as players, LinkedIn and X embed
    through the frames their own widgets use, and anything else falls back to
    a link card. The strip scrolls sideways, so an entry with ten links takes
    the same vertical room as one with two.
    Captions sit above the media rather than below: post embeds are portrait
    and video embeds are 16:9, so bottom captions would sit at different
    heights across a row.
    Seeded with every Loom link already in the repo READMEs, routed by
    subject — grasping demos to the gripper, MoveIt to the arm — plus the
    LinkedIn an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
2026-08-09 Add dexterous hand V3 CAD and printable STLs (#34)
    * Add dexterous hand V3 CAD and printable STLs
    Fills in the V3 placeholder with the SolidWorks hand assembly and the first
    five printable meshes. V3 is the Barrett-style revision: 8 joints driven by
    4 DYNAMIXEL X-series servos via three underactuated 2-link fingers and one
    mechanically coupled spread DOF.
    cad/ carries the top-level dex_hand.SLDASM plus per-part sources, including
    the underactuation coupler and the module-2 spread gear. stl/ carries the
    palm, proximal link, distal link, and finger base.
    README goes from placeholder to partial release: adds the file map, a
    measured dimensions table (bounding box, volume, mesh integrity take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
    [Part14_onlycoupler^dex_hand.SLDPRT, Part16_straight^dex_hand.SLDPRT, Part16_straight^dex_hand.STL, Part17.SLDPRT, XL,XC-330.SLDASM, XL,XC-330.SLDPRT, XL,XC-330.stp, base.SLDPRT]
2026-08-10 chore: use PathOn branding and PathOnRoboticsOSS repo name
    The repo was renamed from pathon_opensource to PathOnRoboticsOSS, so
    update the GitHub links that still pointed at the old name (badges,
    website project links, robot content frontmatter).
    Also fix the company name casing throughout: Pathon -> PathOn in all
    user-facing prose, page metadata, and the URDF/MJCF model names.
    PATHON_MAKER and the maker: values in website/content move together so
    the "Built by PathOn" filter keeps matching.
    The ROS2 driver listed "PathOn Robotics" as maintainer with a personal
    address; point it at info@pathon.ai like the privacy policies.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
    [so101_PathonAI_6dof_symmetric_gripper.urdf]
2026-08-10 docs(dexterous_hand): flag V2 as reference only, point active work at V3
    Assembling a physical V2 turned up problems the READMEs did not mention.
    The released STL set has no intermediate link to carry the second servo
    on the first servo's output, so that servo ends up grounded to the palm
    and its joint cannot articulate. The servo also is not captured by its
    open C-channel mount, and the leads exit through the joint gap with no
    strain relief. With no CAD source in the release, none of it can be
    fixed from the published files.
    Mark V2 as reference only, published as-is, in both the version index
    and its own README, and record the issues so nobody spends a print
    finding them again. V2 is a vo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
2026-08-10 docs(dexterous_hand): host the V3 CAD walkthrough on Loom, drop the mp4
    A 5.4 MB screen capture does not belong in git. Point the README at the
    Loom recording instead, and ignore video files so the next one does not
    land here either.
2026-08-11 docs(website): update the V3 hand page for the partial release
    The V3 entry was written when nothing had shipped, so it carried a
    "files not yet released" banner and an SVG placeholder image. The CAD
    assembly, the first printable STLs, the isometric render and the Loom
    CAD walkthrough have all landed since.
    - Use the real CAD render (hand_iso.webp) and drop the placeholder SVG
    - Add the Loom walkthrough, which auto-embeds like the V1 demo
    - Status is now "Partial release — CAD + first STLs"; add material,
    print bed and file-format specs
    - Replace the placeholder banner with What's Included and Measured vs.
    Target, keeping the README's caveats: the image is a render, no hand
    is assem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
2026-08-11 docs(website): credit the PathOnAI.org collaboration on the index page
    The repo README already describes this as joint work with PathOnAI.org,
    but the site credited PathOn Robotics alone. Name the collaboration in
    the hero, add a section explaining it, and carry the credit site-wide in
    the footer.
2026-09-01 docs: add a placeholder page for the handheld 3D LiDAR scanner
    The scanner is built and working, but the OpenSCAD source, printable
    meshes, and export script are not cleared for release yet. Publish the
    description and the assembly photo now, with the status stated up front
    so nobody goes looking for files that aren't there.
    Claude-Session: https://claude.ai/code/session_014bjbzmMW5M6eZ3hX4WBwBd
2026-09-01 docs(lidar_scanner): fit the photo to the card frame, credit the designer
    The card thumbnail is aspect-video with object-cover, so the 400x636
    portrait was center-cropped down to the handle and base. Pad the website
    copy to 1244x700 on white — the photo's background is already pure white
    — so the card shows the whole scanner uncropped and the detail hero stops
    towering over the text beside it. The repo copy stays portrait; GitHub
    renders it inline at natural size.
    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
2026-09-01 docs: add placeholder pages for the AGV and AMR
    Both are built and demoed in the Smart Logistics Cell, but neither has
    CAD, a BOM, or code to release, so they are marked as placeholders the
    same way the LiDAR scanner is.
    They are deliberately two pages, not one. The AGV shuttles within a work
    cell on tape stuck to the floor, with no map and no localization; the AMR
    carries between cells on Nav2, holding a map and planning around
    obstacles. Each page argues its own side of that trade rather than
    treating the AGV as a cheaper AMR — running both on one line is the point
    of the cell.
    Photos are frames from the cell demo, the only material that exists.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
2026-09-01 docs: add a placeholder page for the conveyor
    The third station of the Smart Logistics Cell, and the one that makes the
    others a line: a block rides the belt to an IR-monitored pick point, and
    that sensor firing is what starts the sequence. Built and running, but
    with no CAD, BOM, or firmware to release, so it lands as a placeholder
    like the AGV and AMR.
    Photo is cropped from the cell demo video — the only material that
    exists — so it is soft, and worth replacing with a real photo later.
    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
2026-09-01 website: split entry kinds into robot, end effector, mount, equipment
    Two kinds could not describe the catalog. The rule filed anything with a
    motor as "robot", so five end effectors — three dexterous hands, the
    Amazing Hand, the symmetric gripper — were badged "Robot", and the
    conveyor was too. Anything else fell to "part", which renders as "Mount &
    Adapter", so the handheld scanner was labelled a mount.
    Each kind is now defined by what an entry is rather than what it lacks,
    and the deep-link guard validates against KIND_LABELS instead of a
    hardcoded pair, so a fifth kind will not silently break it.
    Note: the homepage category browser lists kind === "robot", so Dexterous
    Hand and Grip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
2026-09-01 hardware: group projects into robots, end effectors, mounts, equipment
    The folder was nine projects in a flat list, which said nothing about how
    they relate. Group them by what a thing is, matching the entry kinds the
    website now uses, and add hardware/README.md as the folder's index — it
    renders when you browse to hardware/ on GitHub, and carries a table of
    the old paths so anyone following a stale link can find where a project
    went.
    Split the SO-101 kit along the same line. The wrist upgrade is a robot
    part and the gripper is an end effector, so they cannot share a folder
    under this scheme. They remain one build: the gripper frame mounts onto
    the yaw link, so its guide opens with that p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
    [11.stl, 12.stl, 21.stl, 22.stl, Body17.stl, Dex_hand.3mf, Feetech SCS0009 v9.stl, Finger.stl]
2026-09-01 hardware: name the gripper for what it is, not what it bolts to
    "SO-101 Symmetric Gripper" put the host arm in the name of a part whose
    distinguishing feature is the rack-and-pinion mechanism. Rename it to
    "Symmetric Gripper" and move the folder to end_effectors/symmetric_gripper/.
    Compatibility is not lost, just relocated: the prerequisite callout, the
    Getting Started steps, and the assembly guide all still say the frame
    mounts onto the 6DoF wrist's yaw link.
    The website slug stays so101-symmetric-gripper — that URL is live, and a
    display-name change does not warrant breaking it.
    Claude-Session: https://claude.ai/code/s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
    [Parallel_gripper_assembly.step, cam.stl, frame.stl, l_gripper.stl, r_gripper.stl, rack_down.stl, rack_up.stl]
2026-09-02 docs: add a placeholder for the OpenArm leader arm
    A 3D-printable leader for teleoperating OpenArm V2, still in development
    — no CAD, no BOM, no meshes, no photos. The page states the design intent
    and, more usefully, the boundary: OpenArm is quasi-direct-drive, so
    current sensing doubles as torque sensing, and a high-ratio printed
    leader's friction and backlash swamp that signal. Force feedback needs a
    quasi-direct-drive leader; this one is position-only by construction.
    Entry kinds now allow a missing image. Placeholder projects get published
    before there is anything to photograph, and the previous code turned an
    absent field into src="/opensourceundefined" — a broken image on every
    c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
2026-09-05 license: cover the hardware, and license it for personal use only
    The root LICENSE only ever spoke about "software" -- the words hardware, CAD,
    STL, and documentation never appear in it. That left every mesh, STEP file,
    assembly photo, and BOM under hardware/ with no grant at all, which defaults to
    all rights reserved: stricter than intended, and unclear to anyone who wanted
    to print a gripper. Only two of ten project READMEs mentioned licensing.
    Give hardware/ its own LICENSE carrying the Standard Digital File License terms
    we already publish the models under on MakerWorld, and point every project
    README at it so the terms sit one click from the files they cover. Scope the
    root LICENSE to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
2026-10-23 Fix piper leader servo mount orientation and align mounting holes
    Update upper_arm, lower_arm and pitch STLs with a revised servo mount so the
    servo installs in the correct orientation with its mounting holes aligned for
    a proper fit. Reorganize the CAD folder into cad/step and cad/stl, and update
    the README links, file tree and add a note on the servo mount change.
2026-10-23 Add OpenArm leader CAD files and documentation
2026-10-23 docs(openarm_leader): fix garbled characters in README, add strap links
    Restore ×, – and the file-tree box-drawing characters that were saved as
    "?", matching the Piper leader README. Add links to the straps used on the
    leader arm.
2026-10-23 docs(openarm_leader): label strap links by joint (4 and 6)
2026-10-23 docs(openarm_leader): add assembled arm photo to README
2026-10-27 docs(website): update OpenArm leader page with isometric render and released specs
    Replace the placeholder entry with the released design: isometric CAD render,
    8x Feetech STS3215-C046 servos, 11 printed parts (STEP + STL), largest part
    159 mm, servo ID setup, and straps for joints 4 and 6.
2026-10-27 docs(website): mark Dexterous Hand V3 render and STEP/STL files as pending
    Drop the CAD render from the V3 entry so the page shows the placeholder panel,
    note that renders are to be released, and mark the released CAD/STL files as an
    early cut that will be updated, with a STEP export still to come.
2026-10-27 docs(dexterous_hand): mark V3 as not finalized with a new revision in progress
    Family README, V3 README status note, and top-level README row now say the
    released V3 CAD/STL are an early cut that will be updated.
2026-11-02 docs(readme): OpenArm Leader Arm is released, drop the placeholder tag
    STEP/STL for the 11 printed parts, renders, assembled photo and the teleop demo
    are in hardware/robots/openarm_leader/ since 0983a4a–4236328; the catalog row
    now matches the project README.
2026-11-03 dexterous_hand/v3: release the as-built 4-motor hand (STLs, guide and video)
    Replace the V3 placeholder with the hand that is built and running on our
    robot since 2026-10-15: 3 fingers on four DYNAMIXEL XL330-M288-T servos (one
    per finger plus a geared spread drive), soft printed fingertips.
    - hardware/end_effectors/dexterous_hand/v3: 13 printable STLs, CAD renders,
    README with specs, parts and counts, print settings and roadmap
    - Links to the hosted interactive assembly guide (https://web-6gov.vercel.app/)
    and the bear pick-up demo video (Loom, 2026-10-19); the guide's source,
    STEP files, URDF and bring-up scripts are not part of this release
    - Update the dexterous_hand index, the ro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
